trunksx64/KICAD_LIBRARY/3dmodels/x_Buzzer.3dhapes/AT_1224_TWT_5V_2_R.step

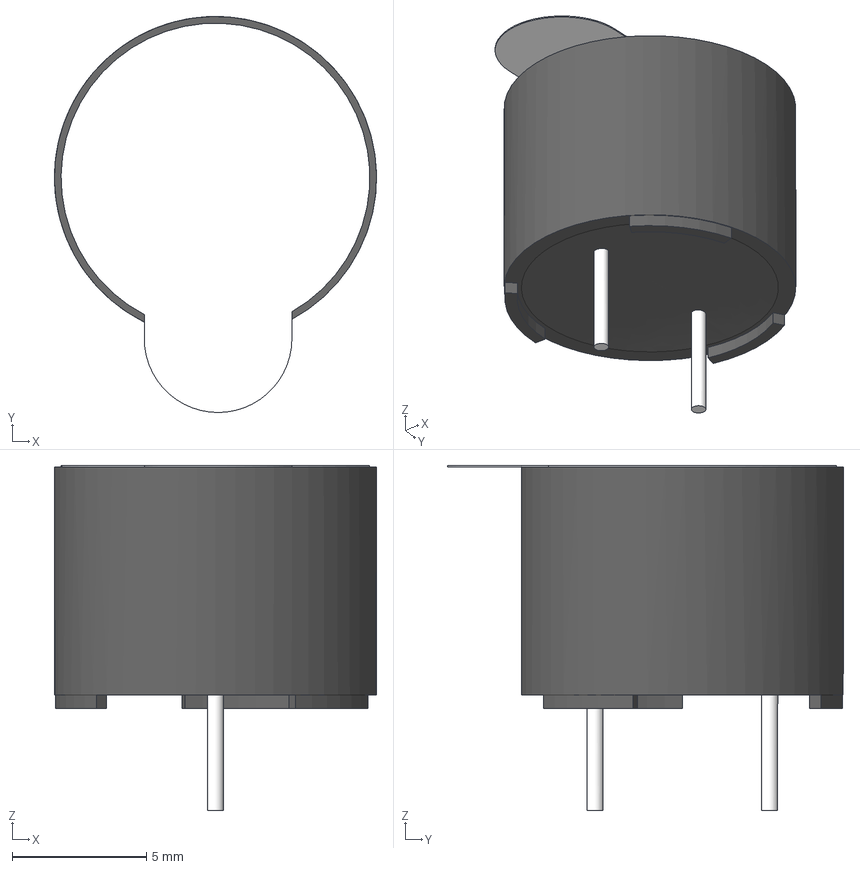
[picture p4: CAD file, 2026-03-22]
3dmodels/x_Buzzer.3dhapes/AT_1224_TWT_5V_2_R.step
12.0 x 14.7 x 12.9 mm
