trunksx64/KICAD_LIBRARY/3dmodels/x_Capacitors/KR-5R5V224-R.step

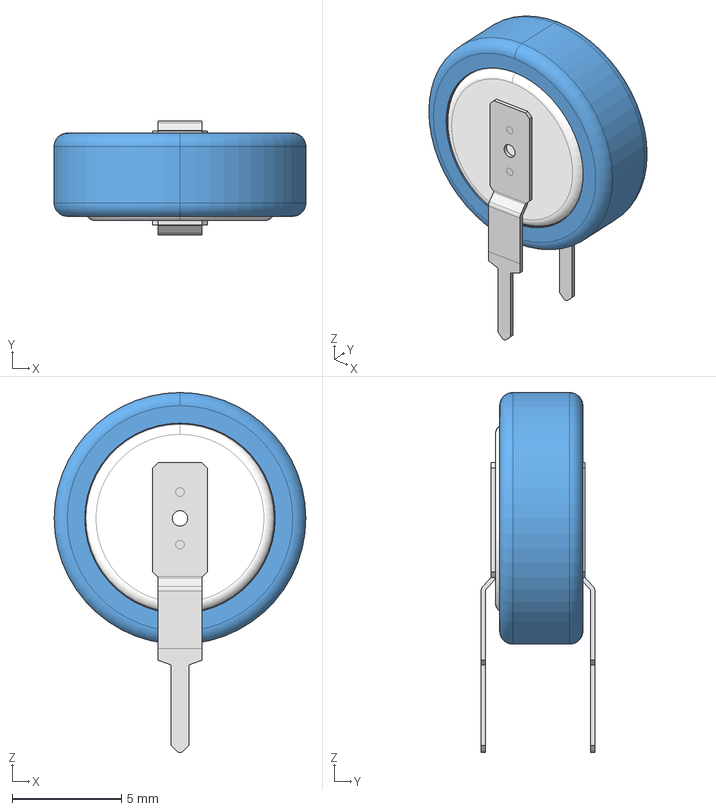
[picture p5: CAD file, 2026-02-24]
3dmodels/x_Capacitors/KR-5R5V224-R.step
11.5 x 5.20 x 16.4 mm
KR-5R5V104_224_334_474-R
KR-5R5V104_224_334_474-R001
KR-5R5V104_224_334_474-R002
KR-5R5V104_224_334_474-R003
KR-5R5V104_224_334_474-R004
KR-5R5V104_224_334_474-R005
