trunksx64/KICAD_LIBRARY/freecad/x_Arduino_Shield/ARDUINO_UNO_R3_PIN_HEADER.FCStd

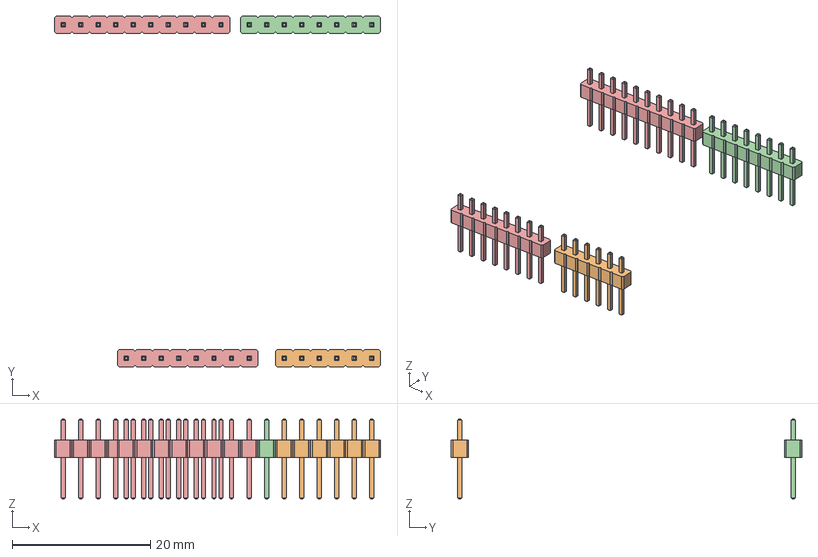
[picture p6: CAD file, 2025-01-12]
freecad/x_Arduino_Shield/ARDUINO_UNO_R3_PIN_HEADER.FCStd
47.2 x 50.8 x 11.5 mm
PinHeader_1x08_P254mm_001
PinHeader_1x06_P254mm_001
PinHeader_1x10_P254mm_001
PinHeader_1x08_P254mm_002
ARDUINO_UNO_R3_PIN_HEADER
