trunksx64/KICAD_LIBRARY/freecad/x_Battery/MS920SE_FL27E.FCStd

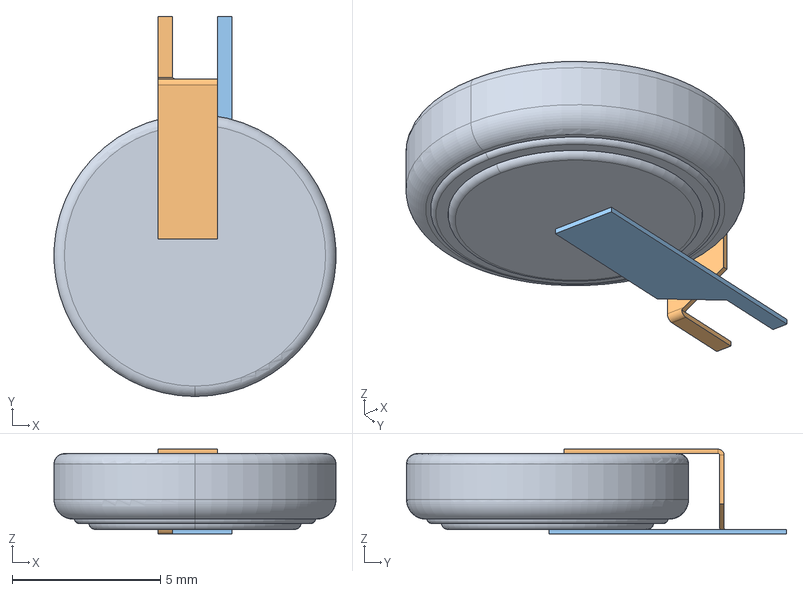
[picture p7: CAD file, 2025-09-22]
freecad/x_Battery/MS920SE_FL27E.FCStd
9.49 x 12.8 x 2.85 mm
MS920SE-FL27E_BODY
MS920SE-FL27E_PIN_P
MS920SE-FL27E_PIN_N
