trunksx64/KICAD_LIBRARY/freecad/x_Button_Switch_SMD/SWITCH_TACTILE_SPST_12x12mm_SMD.FCStd

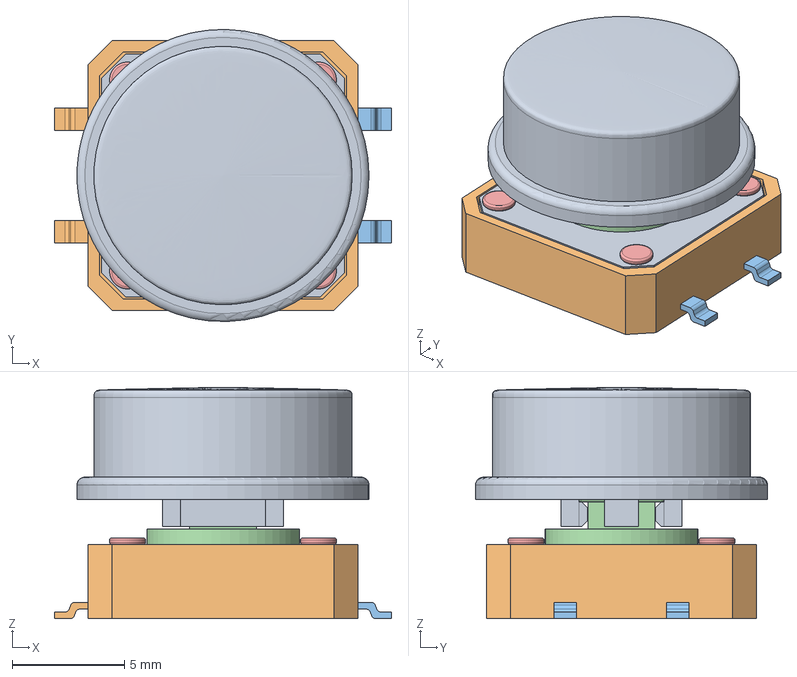
[picture p8: CAD file, 2025-01-12]
freecad/x_Button_Switch_SMD/SWITCH_TACTILE_SPST_12x12mm_SMD.FCStd
15.0 x 13.0 x 10.3 mm
Case
Base
PushFLat
PushSuport
ArrayLocks
Blue
Green
Red
Yellow
PinAS
PinBS
