trunksx64/KICAD_LIBRARY/freecad/x_Button_Switch_THT/SWITCH_TACTILE_SPST_6x3.5mm_THT.FCStd

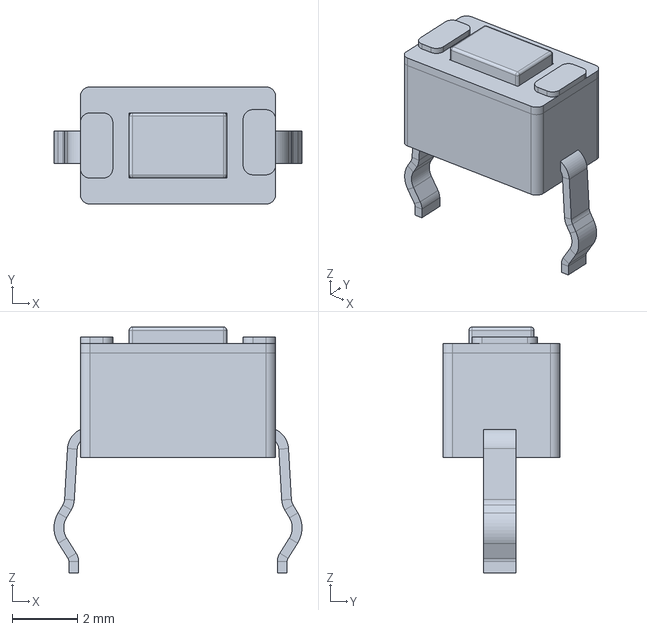
[picture p9: CAD file, 2025-07-24]
freecad/x_Button_Switch_THT/SWITCH_TACTILE_SPST_6x3.5mm_THT.FCStd
7.61 x 3.60 x 7.55 mm
