trunksx64/KICAD_LIBRARY/freecad/x_Connector_Card/DM3AT_SF_PEJM5.FCStd

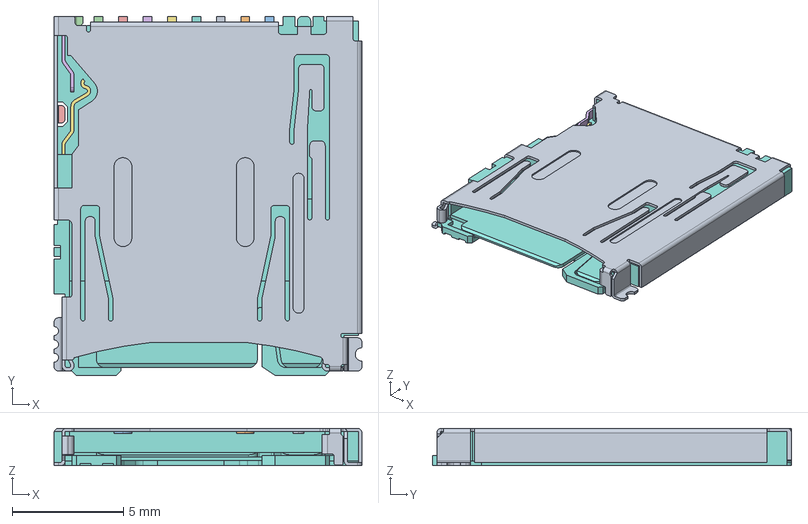
[picture p10: CAD file, 2025-05-25]
freecad/x_Connector_Card/DM3AT_SF_PEJM5.FCStd
13.8 x 16.2 x 1.68 mm
DM3AT-SF-PEJM5
DM3AT-SF-PEJM006
DM3AT-SF-PEJM007
DM3AT-SF-PEJM008
DM3AT-SF-PEJM009
DM3AT-SF-PEJM010
DM3AT-SF-PEJM011
DM3AT-SF-PEJM012
DM3AT-SF-PEJM013
DM3AT-SF-PEJM014
DM3AT-SF-PEJM015
DM3AT-SF-PEJM016
DM3AT-SF-PEJM017
DM3AT-SF-PEJM018
DM3AT-SF-PEJM019
DM3AT-SF-PEJM020
DM3AT-SF-PEJM021
