trunksx64/KICAD_LIBRARY/freecad/x_Connector_FFC_FPC/TE_4_1734839_0_1x40_1MP_P0.5mm_H.FCStd

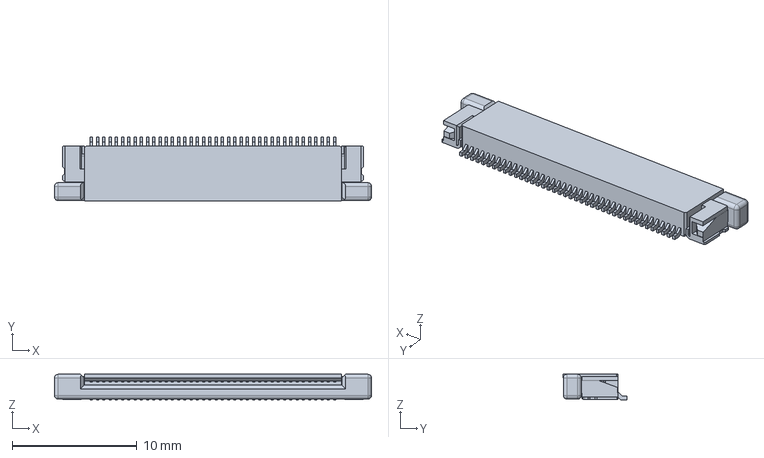
[picture p11: CAD file, 2025-01-12]
freecad/x_Connector_FFC_FPC/TE_4_1734839_0_1x40_1MP_P0.5mm_H.FCStd
25.4 x 5.11 x 2.05 mm
