trunksx64/KICAD_LIBRARY/freecad/x_Connector_FTSH/FTSH_107_01_L_DV_K.FCStd

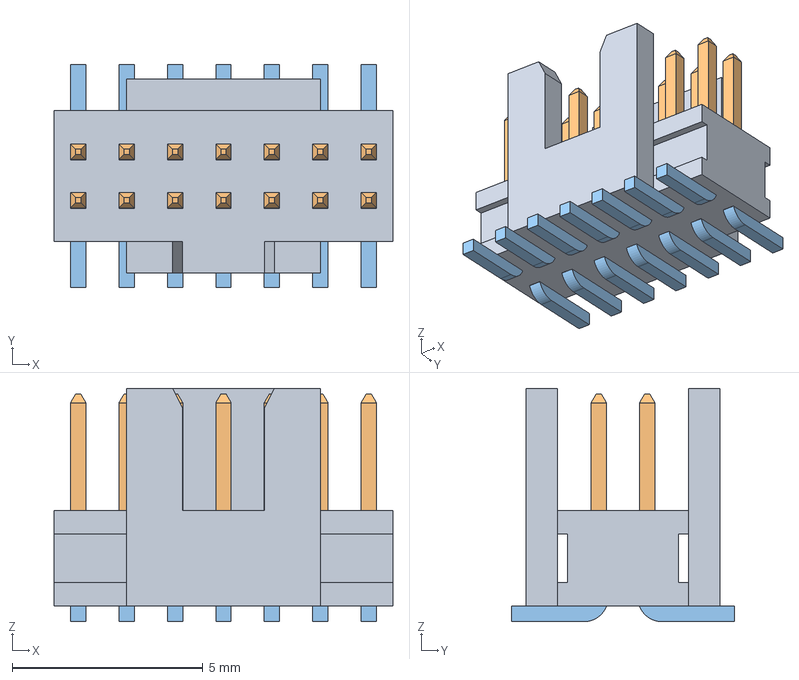
[picture p12: CAD file, 2025-10-27]
freecad/x_Connector_FTSH/FTSH_107_01_L_DV_K.FCStd
8.89 x 5.84 x 6.12 mm
FTSH-107-01-L-DV-K_body
FTSH-107-01-L-DV-K_pins1
FTSH-107-01-L-DV-K_pins2
