trunksx64/KICAD_LIBRARY/freecad/x_Connector_IDC/IDC_Header_2x07_P21.27mm_Vertical.FCStd

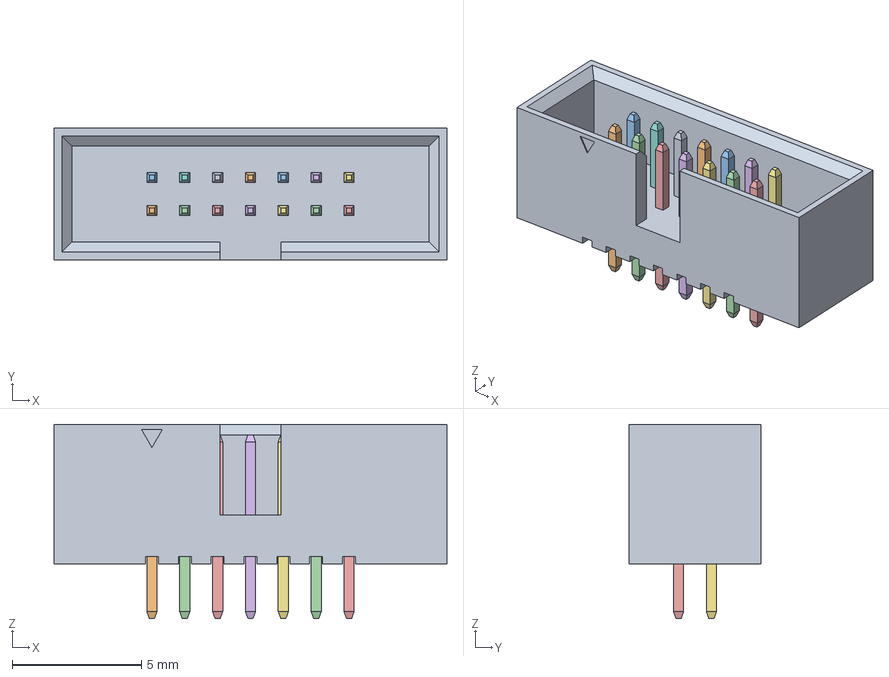
[picture p13: CAD file, 2026-02-07]
freecad/x_Connector_IDC/IDC_Header_2x07_P21.27mm_Vertical.FCStd
15.2 x 5.10 x 7.50 mm
3220-xx-0100-00 body_14
Pin^3220-xx-0100-00
Pin^3220-xx-0100-001
Pin^3220-xx-0100-002
Pin^3220-xx-0100-003
Pin^3220-xx-0100-004
Pin^3220-xx-0100-005
Pin^3220-xx-0100-006
Pin^3220-xx-0100-007
Pin^3220-xx-0100-008
Pin^3220-xx-0100-009
Pin^3220-xx-0100-010
Pin^3220-xx-0100-011
Pin^3220-xx-0100-012
Pin^3220-xx-0100-013
