trunksx64/KICAD_LIBRARY/freecad/x_Connector_Molex/MOLEX_MINI_FIT_02x02_P4.20mm_HORIZONTAL.FCStd

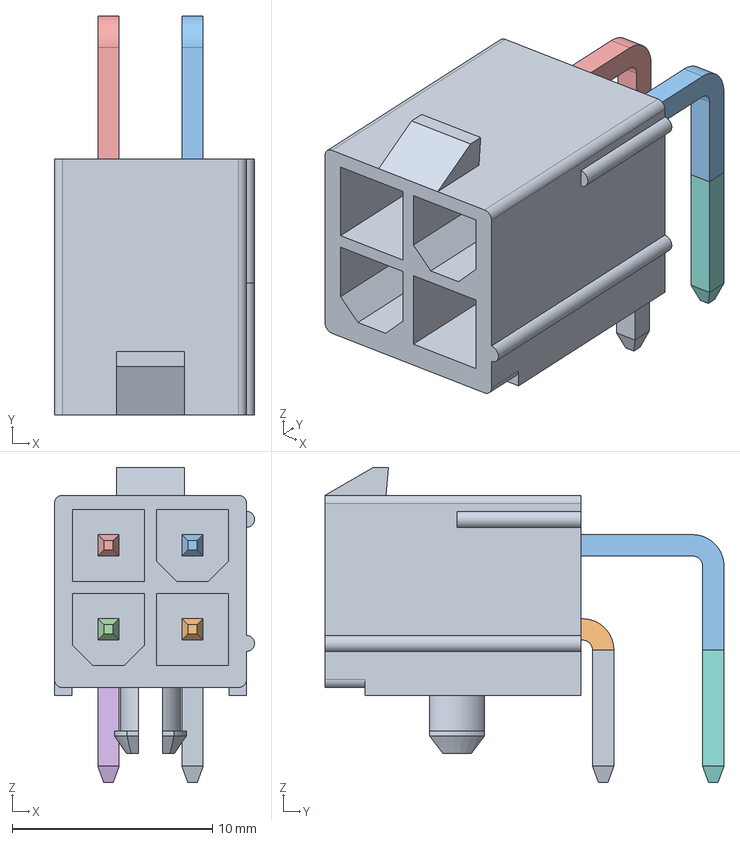
[picture p14: CAD file, 2025-04-12]
freecad/x_Connector_Molex/MOLEX_MINI_FIT_02x02_P4.20mm_HORIZONTAL.FCStd
10.00 x 19.9 x 15.8 mm
