trunksx64/KICAD_LIBRARY/freecad/x_Connector_RJ/RJ12_Vertical.FCStd

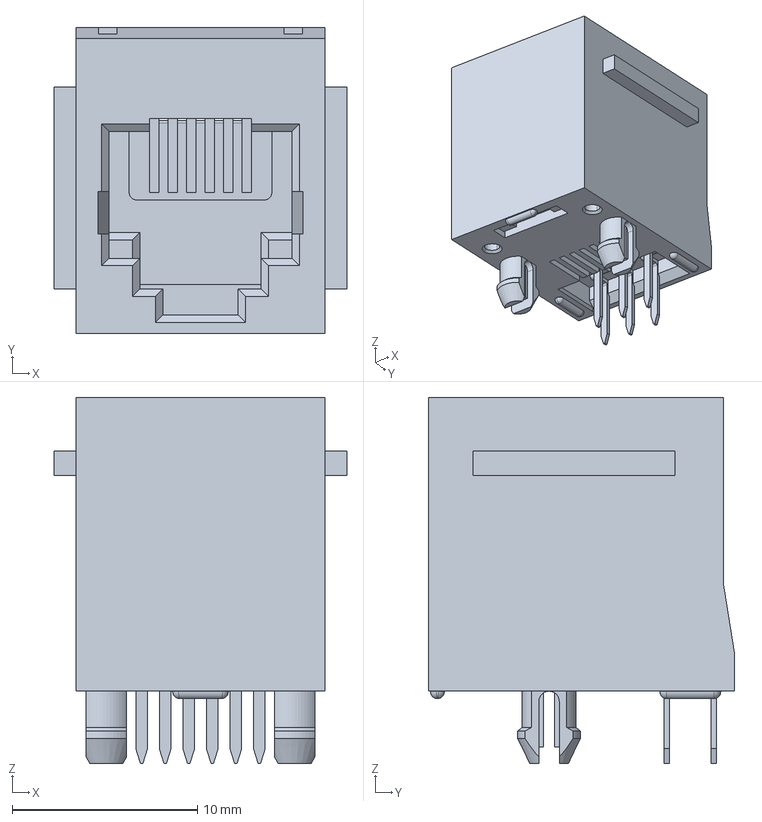
[picture p15: CAD file, 2025-01-12]
freecad/x_Connector_RJ/RJ12_Vertical.FCStd
15.8 x 16.5 x 19.8 mm
