trunksx64/KICAD_LIBRARY/freecad/x_Connector_USB/USB_B_LUMBERG_2411_HORIZONTAL.FCStd

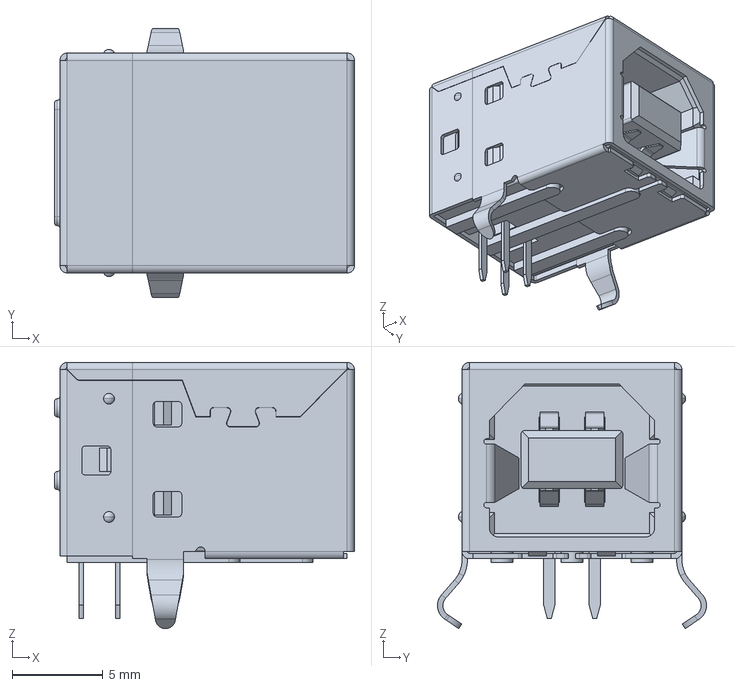
[picture p16: CAD file, 2025-01-12]
freecad/x_Connector_USB/USB_B_LUMBERG_2411_HORIZONTAL.FCStd
16.5 x 14.8 x 14.6 mm
