trunksx64/KICAD_LIBRARY/freecad/x_Crystal/Crystal_SMD_ABS25_4Pin_8.0x3.8mm.FCStd

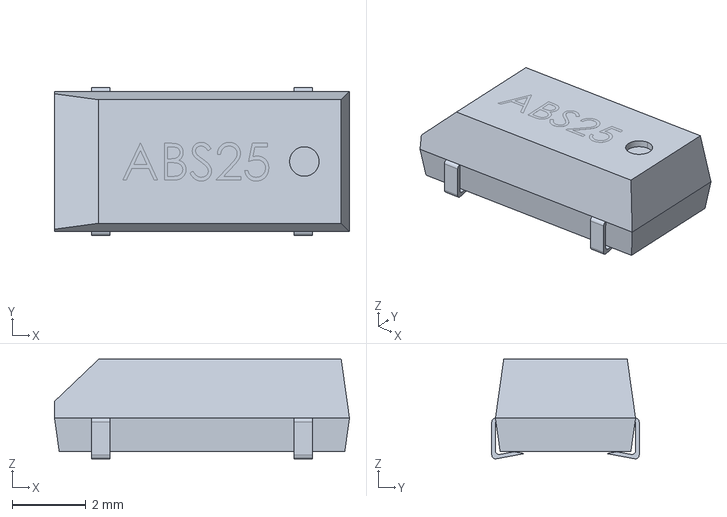
[picture p17: CAD file, 2025-01-12]
freecad/x_Crystal/Crystal_SMD_ABS25_4Pin_8.0x3.8mm.FCStd
8.00 x 4.00 x 2.71 mm
