trunksx64/KICAD_LIBRARY/freecad/x_Diode_SMD/DO_214AC(SMA).FCStd

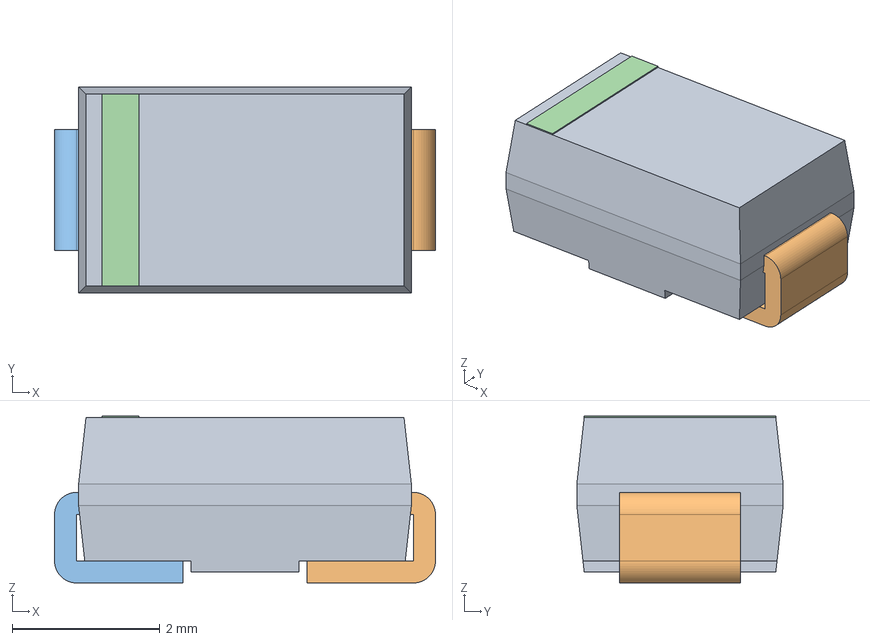
[picture p18: CAD file, 2025-01-12]
freecad/x_Diode_SMD/DO_214AC(SMA).FCStd
5.15 x 2.79 x 2.26 mm
Cut_K
Pin_1K
Pin_2K
Extrude_K
