trunksx64/KICAD_LIBRARY/freecad/x_Display_7Segment/KW3_S561AWB.FCStd

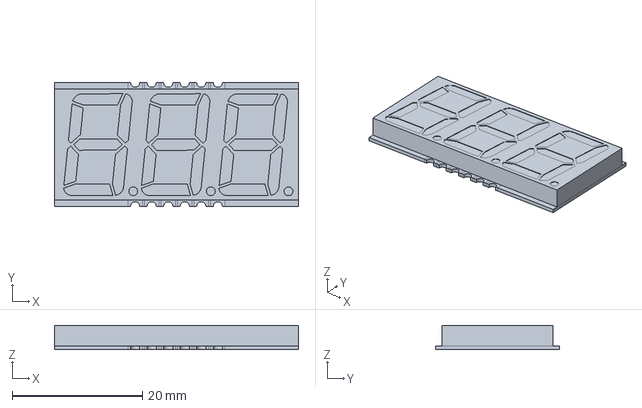
[picture p19: CAD file, 2025-07-22]
freecad/x_Display_7Segment/KW3_S561AWB.FCStd
37.5 x 19.0 x 3.75 mm
