trunksx64/KICAD_LIBRARY/freecad/x_Display_Driver/MAX6951.FCStd

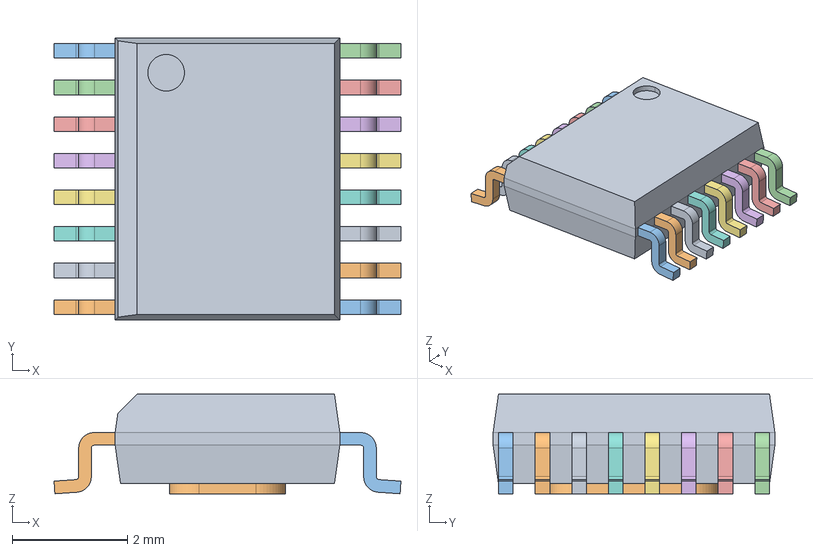
[picture p20: CAD file, 2025-07-24]
freecad/x_Display_Driver/MAX6951.FCStd
6.02 x 4.89 x 1.73 mm
MAX6951_001
MAX6951_002
MAX6951_003
MAX6951_004
MAX6951_005
MAX6951_006
MAX6951_007
MAX6951_008
MAX6951_009
MAX6951_010
MAX6951_011
MAX6951_012
MAX6951_013
MAX6951_014
MAX6951_015
MAX6951_016
MAX6951_017
MAX695_018
