trunksx64/KICAD_LIBRARY/freecad/x_Display_GLCD/GLCD_OLLED_128x32_I2C.FCStd

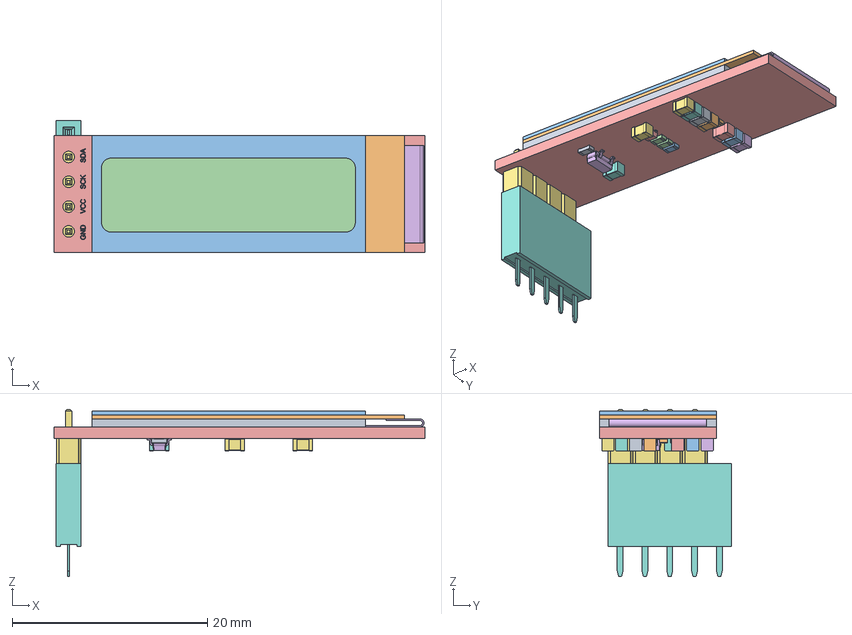
[picture p21: CAD file, 2025-09-22]
freecad/x_Display_GLCD/GLCD_OLLED_128x32_I2C.FCStd
38.0 x 13.6 x 17.2 mm
SCREEN_30x12mm_A
SCREEN_30x12mm_B
SCREEN_30x12mm_C
SCREEN_30x12mm_D
PCB_38x12mm
FLEX
PinHeader_1x04_P254mm_Vertical
PinSocket_1x05_P2.54mm_Vertical
TEXT_GND
TEXT_VCC
TEXT_SCK
TEXT_SDA
D_SC_80
SOT-23-3
C_0805_2012Metric_002
C_0805_2012Metric_003
R_0603_1608Metric_002
R_0603_1608Metric_000
C_0805_2012Metric_000
R_0603_1608Metric_001
C_0805_2012Metric_004
C_0805_2012Metric_005
C_0805_2012Metric_006
C_0805_2012Metric_007
C_0805_2012Metric_008
C_0805_2012Metric_009
R_0603_1608Metric_003
R_0603_1608Metric_004
