trunksx64/KICAD_LIBRARY/freecad/x_Display_Matrix/1088AS.FCStd

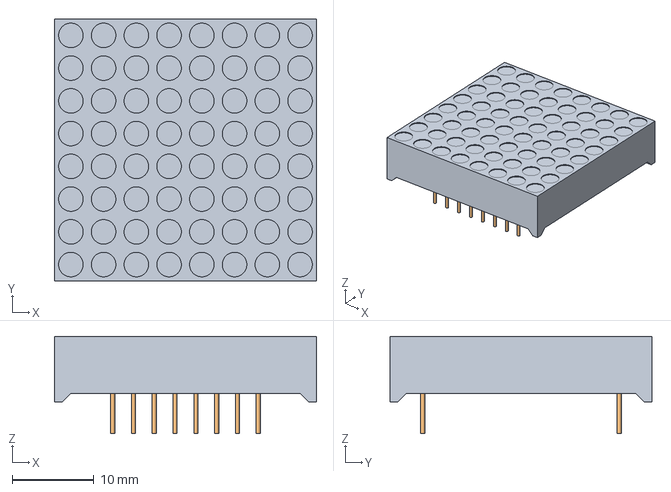
[picture p22: CAD file, 2025-01-12]
freecad/x_Display_Matrix/1088AS.FCStd
32.0 x 32.0 x 11.9 mm
BasePlastic
Pins001
