trunksx64/KICAD_LIBRARY/freecad/x_Fuses/MF_SMDF200.FCStd

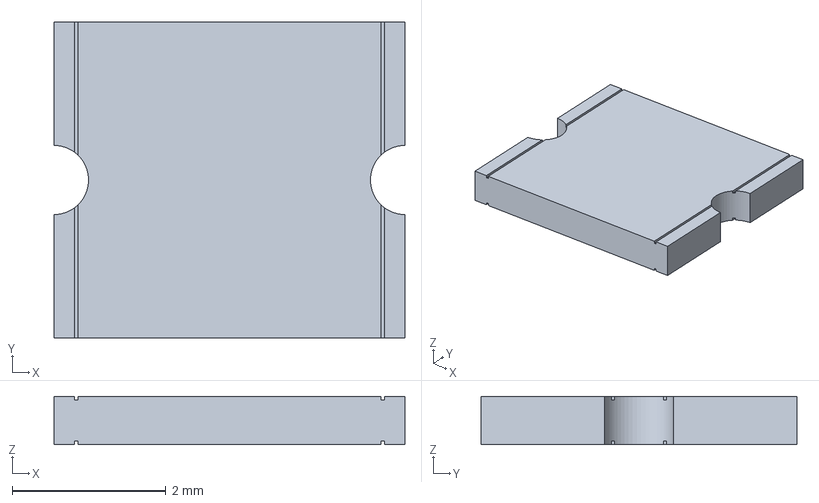
[picture p23: CAD file, 2025-01-12]
freecad/x_Fuses/MF_SMDF200.FCStd
4.57 x 4.12 x 0.63 mm
