trunksx64/KICAD_LIBRARY/freecad/x_Inductor_SMD/L_Bourns_SRN1060.FCStd

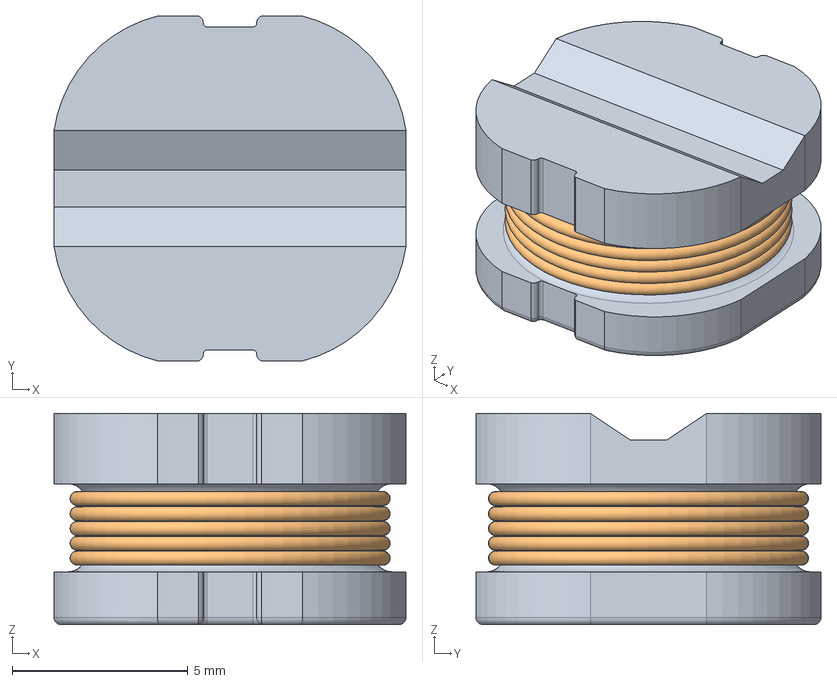
[picture p24: CAD file, 2025-01-12]
freecad/x_Inductor_SMD/L_Bourns_SRN1060.FCStd
10.0 x 9.80 x 6.00 mm
L_Bourns-SRN1060
