trunksx64/KICAD_LIBRARY/freecad/x_Inductor_THT/AC_COMMON_COIL_H16.2mm_W21.0mm_Py10.mm_Px13.mm.FCStd

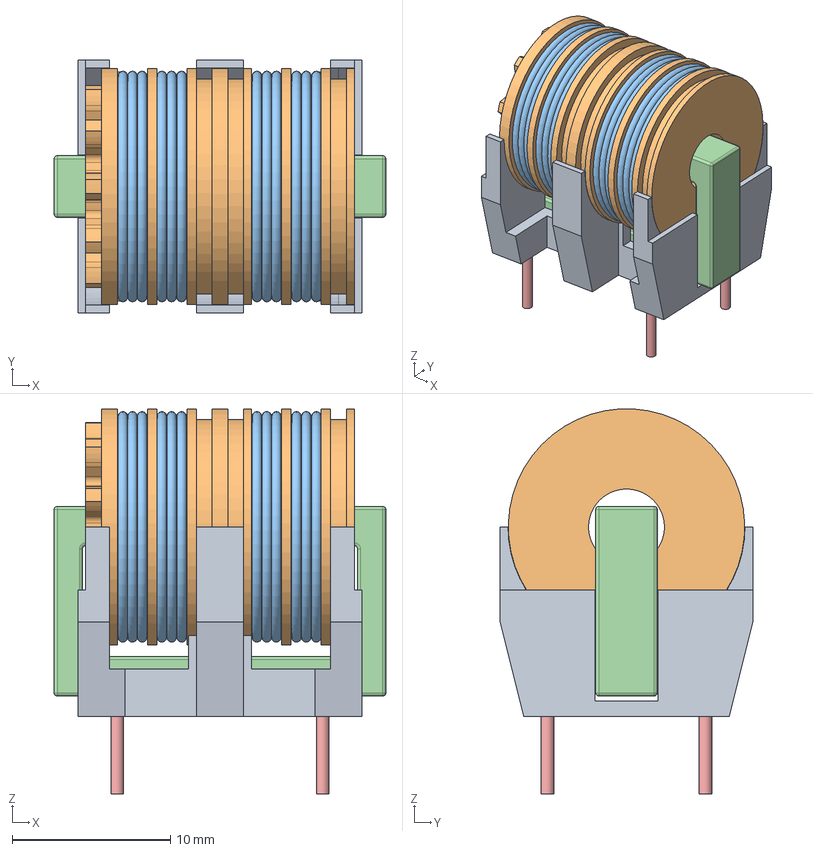
[picture p25: CAD file, 2025-01-12]
freecad/x_Inductor_THT/AC_COMMON_COIL_H16.2mm_W21.0mm_Py10.mm_Px13.mm.FCStd
21.0 x 16.0 x 24.4 mm
Base_K
Plastic_K
Copper_K
Ferrite_K
Pins_K
