trunksx64/KICAD_LIBRARY/freecad/x_Joystick/JOYSTICK_ALPS_3318.FCStd

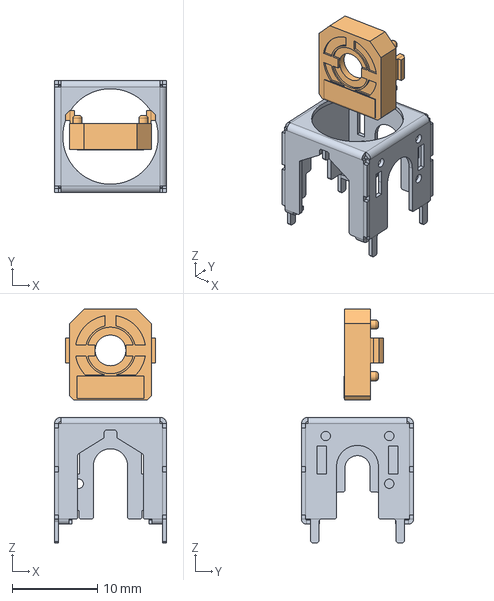
[picture p26: CAD file, 2025-01-12]
freecad/x_Joystick/JOYSTICK_ALPS_3318.FCStd
13.2 x 13.2 x 27.5 mm
CHASSIS
CONTROLLER
