trunksx64/KICAD_LIBRARY/freecad/x_Jumpers/JUMPER_2.54MM.FCStd

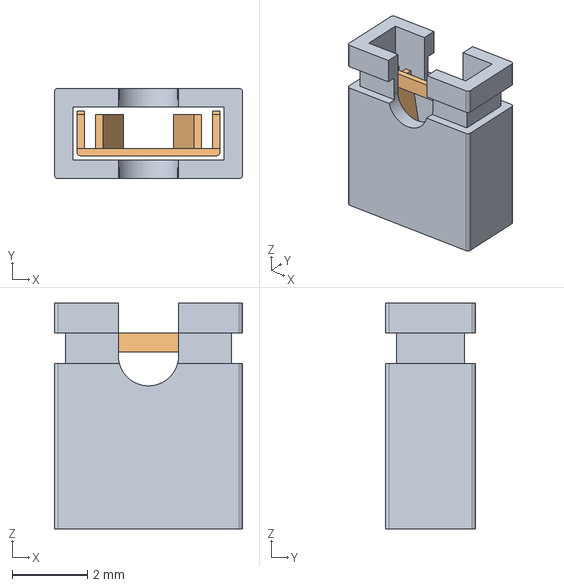
[picture p27: CAD file, 2025-01-12]
freecad/x_Jumpers/JUMPER_2.54MM.FCStd
5.00 x 2.40 x 6.00 mm
COPPER
PLASTIC
