trunksx64/KICAD_LIBRARY/freecad/x_Led_SMD/LED_1210RVC.FCStd

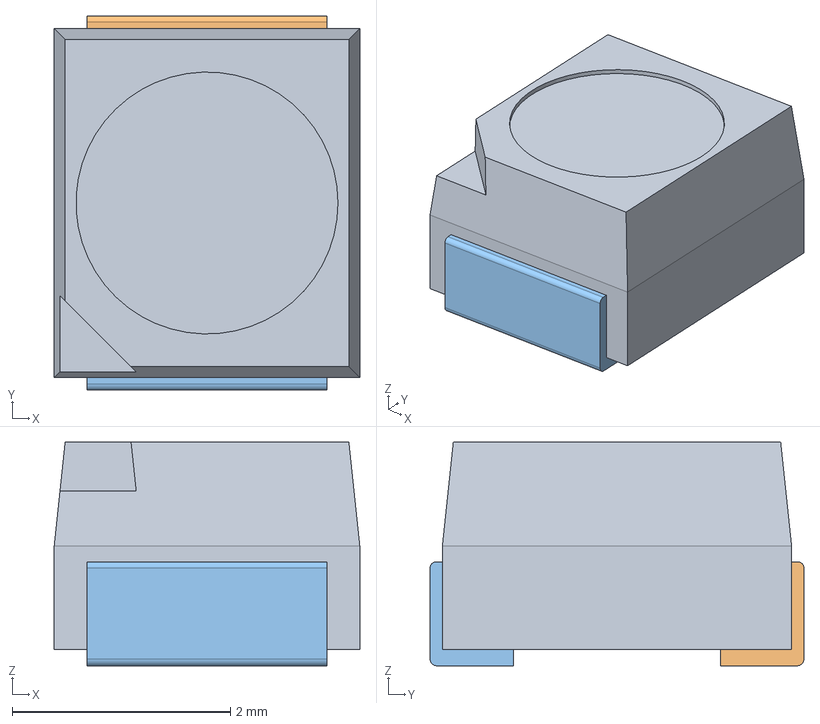
[picture p28: CAD file, 2025-01-12]
freecad/x_Led_SMD/LED_1210RVC.FCStd
2.80 x 3.43 x 2.05 mm
Plastic
PinPad1
PinPad2
