trunksx64/KICAD_LIBRARY/freecad/x_Module/BREAKOUT_BOAD_LQFN64.FCStd

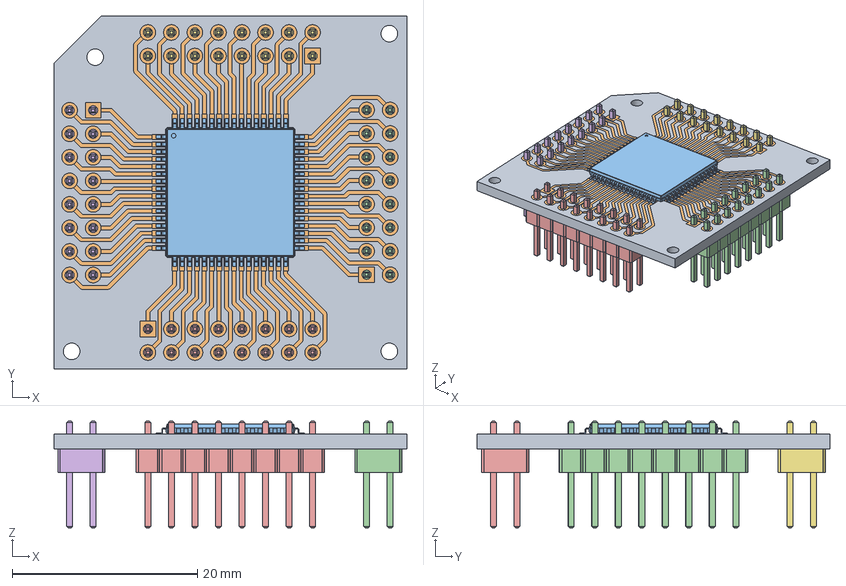
[picture p29: CAD file, 2025-01-12]
freecad/x_Module/BREAKOUT_BOAD_LQFN64.FCStd
38.1 x 38.1 x 11.5 mm
PCB
TRACKS
TQFP_64
PIN_HEADER_001
PIN_HEADER_002
PIN_HEADER_003
PIN_HEADER_004
