trunksx64/KICAD_LIBRARY/freecad/x_OptoDevice/PHOTO_CELL_VT900.FCStd

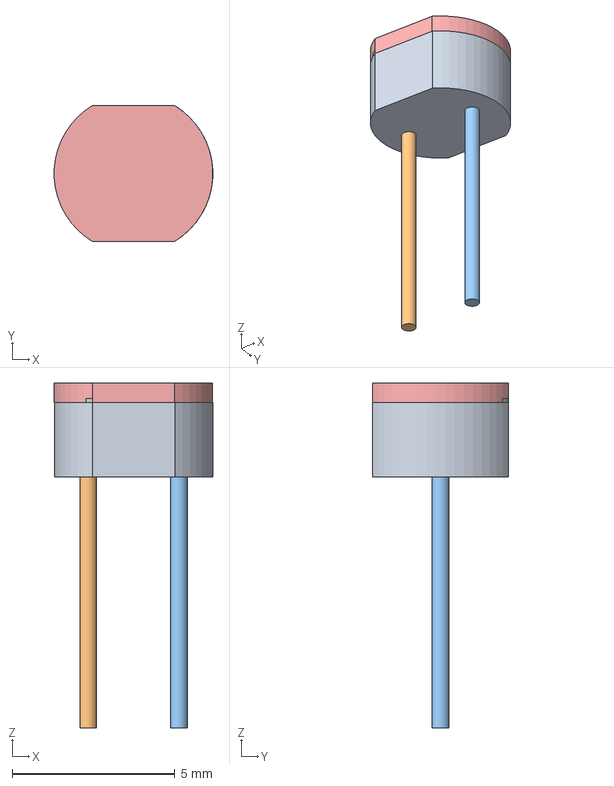
[picture p30: CAD file, 2025-01-12]
freecad/x_OptoDevice/PHOTO_CELL_VT900.FCStd
4.87 x 4.17 x 10.6 mm
Pin001
Pin002
Resistencia001
Glass001
