trunksx64/KICAD_LIBRARY/freecad/x_Package_DFN_QFN/QFN_16_3x3x1mm_P0.5mm.FCStd

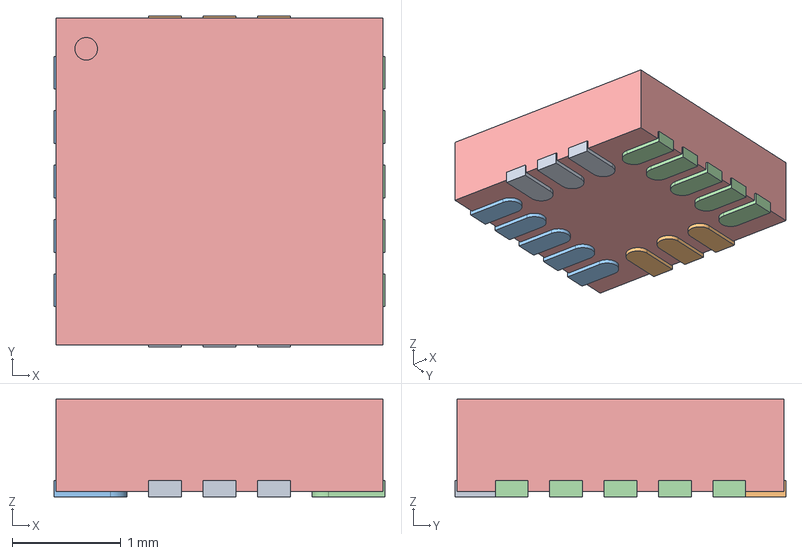
[picture p31: CAD file, 2025-01-12]
freecad/x_Package_DFN_QFN/QFN_16_3x3x1mm_P0.5mm.FCStd
3.04 x 3.04 x 0.9 mm
Pins1
Pins2
Pins3
Pins4
Resine
