trunksx64/KICAD_LIBRARY/freecad/x_Package_DIP/SMDIP_6_W8.51mm.FCStd

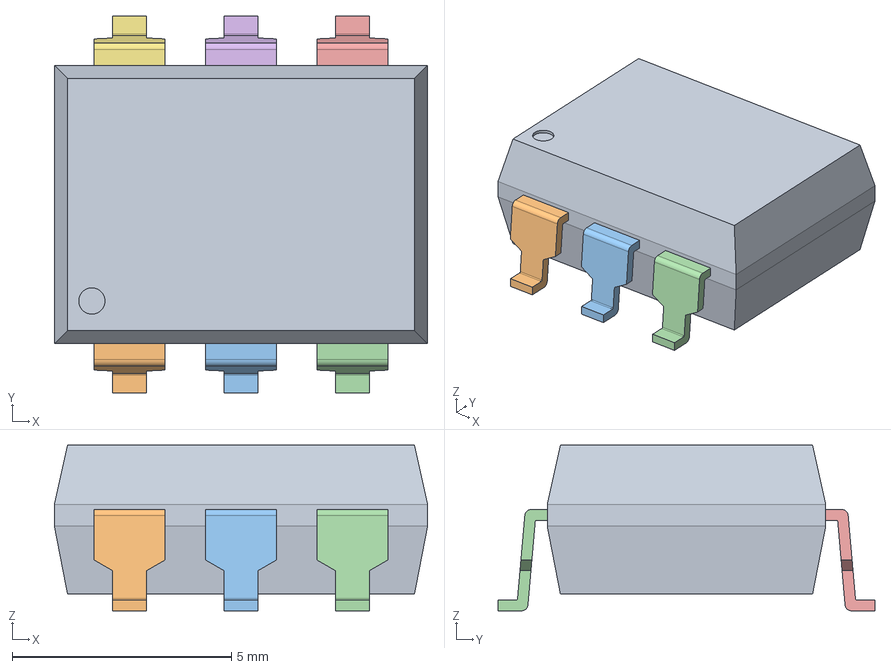
[picture p32: CAD file, 2025-01-12]
freecad/x_Package_DIP/SMDIP_6_W8.51mm.FCStd
8.51 x 8.60 x 3.78 mm
Body_K
Pin01_K
Pin02_K
Pin03_K
Pin04_K
Pin05_K
Pin06_K
