trunksx64/KICAD_LIBRARY/freecad/x_Package_QFP/LQFN_44_10x10x1.4mm_P0.8mm_EP5.2x5.2mm.FCStd

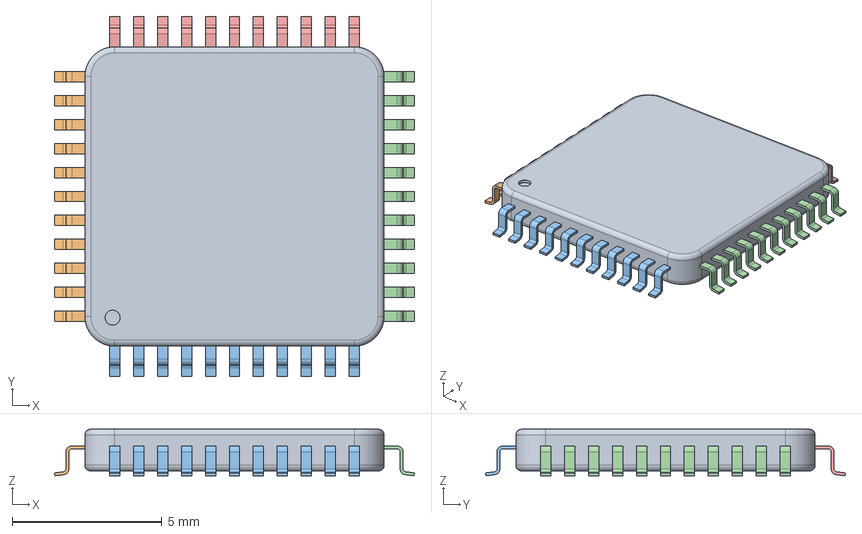
[picture p33: CAD file, 2025-01-12]
freecad/x_Package_QFP/LQFN_44_10x10x1.4mm_P0.8mm_EP5.2x5.2mm.FCStd
12.0 x 12.0 x 1.56 mm
Resine
Pin1
Pin2
Pin3
Pin4
