trunksx64/KICAD_LIBRARY/freecad/x_Package_TO_SOT_THT/SOT-523.FCStd

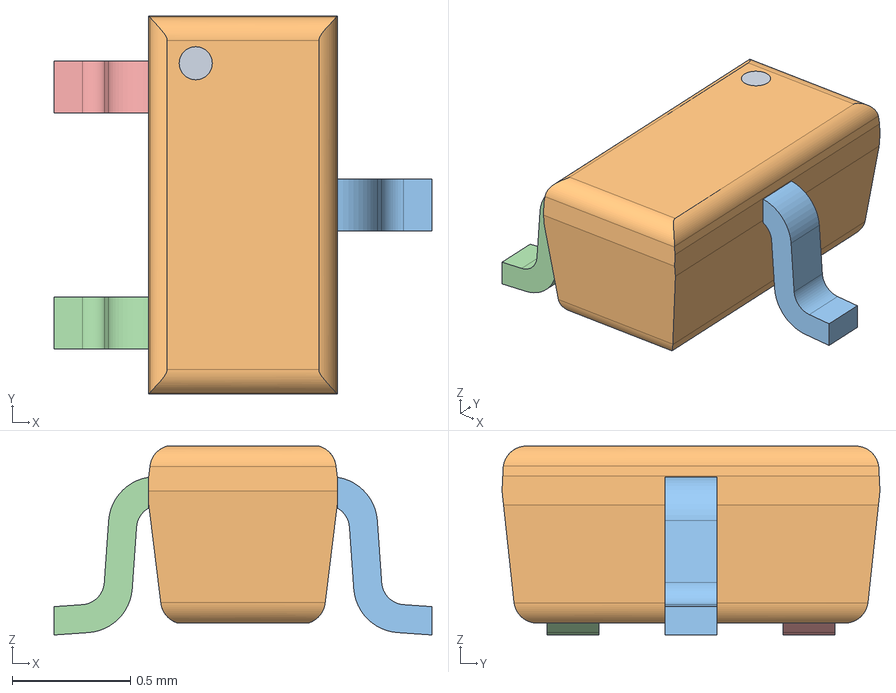
[picture p34: CAD file, 2026-02-24]
freecad/x_Package_TO_SOT_THT/SOT-523.FCStd
1.60 x 1.60 x 0.8 mm
SOT-523-F
SOT-523-F001
SOT-523-F002
SOT-523-F003
SOT-523-F004
