trunksx64/KICAD_LIBRARY/freecad/x_Relay_THT/HRS2H_S.FCStd

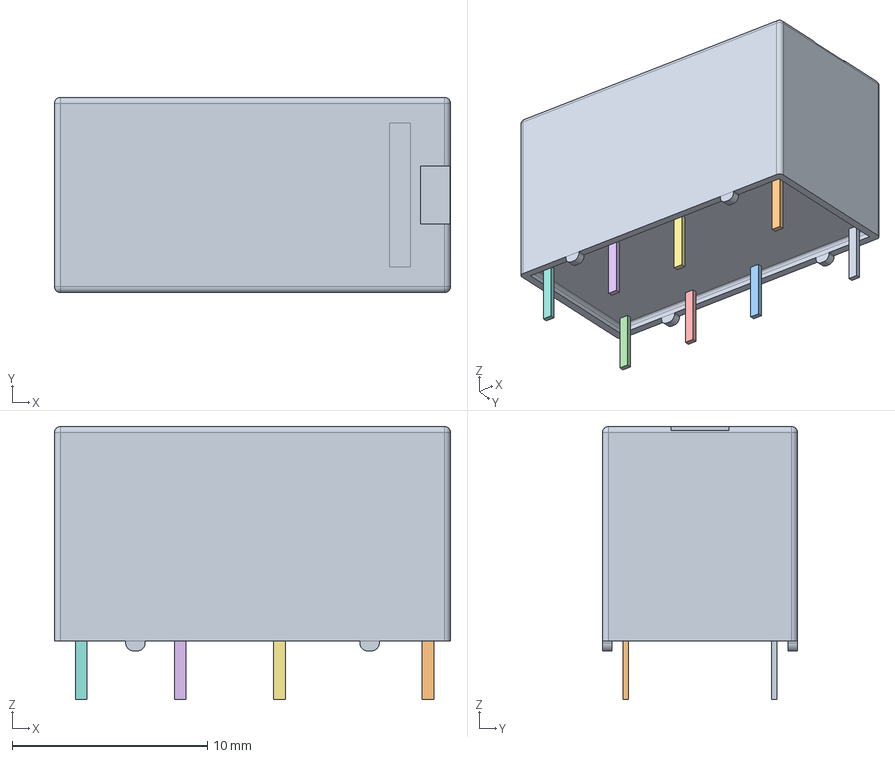
[picture p35: CAD file, 2025-01-12]
freecad/x_Relay_THT/HRS2H_S.FCStd
20.3 x 10.0 x 14.0 mm
Body_B
PIN_016
PIN_015
PIN_014
PIN_013
PIN_012
PIN_011
PIN_010
PIN_009
