trunksx64/KICAD_LIBRARY/freecad/x_Sockets_ZIF/SOCKET_28P_W50.4_H14.9_P7.62x2.45.FCStd

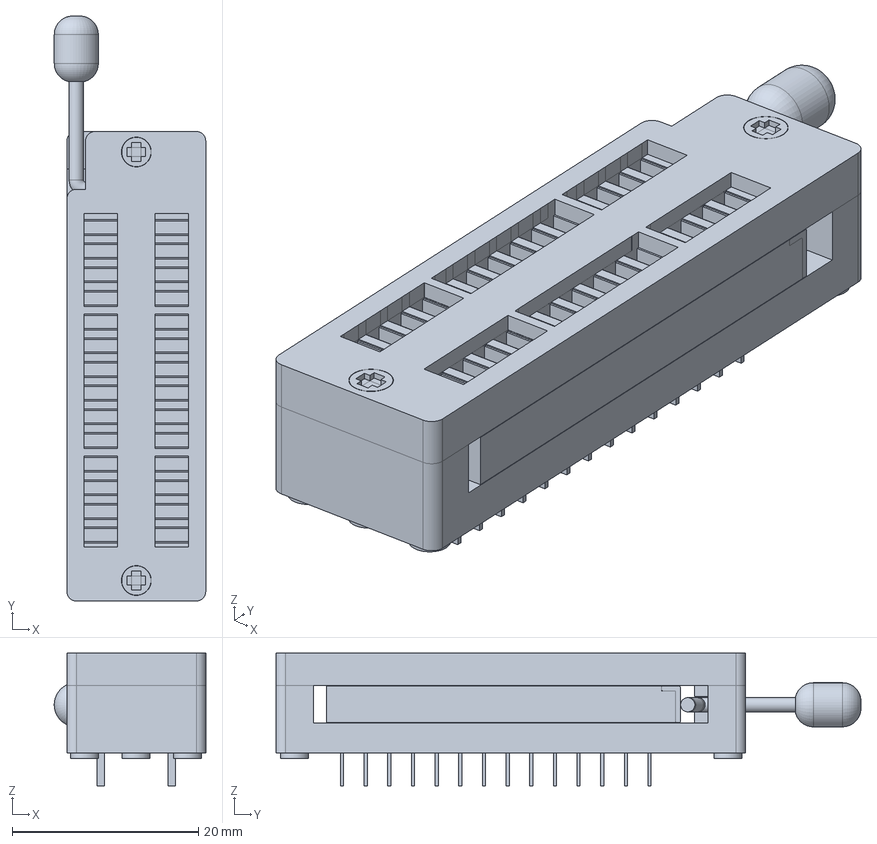
[picture p37: CAD file, 2025-07-22]
freecad/x_Sockets_ZIF/SOCKET_28P_W50.4_H14.9_P7.62x2.45.FCStd
16.3 x 62.8 x 14.3 mm
