trunksx64/KICAD_LIBRARY/3dmodels/x_Capacitors/Cap_Disc_D5.0mm_W2.5mm_H7.8MM_P5.00mm.step

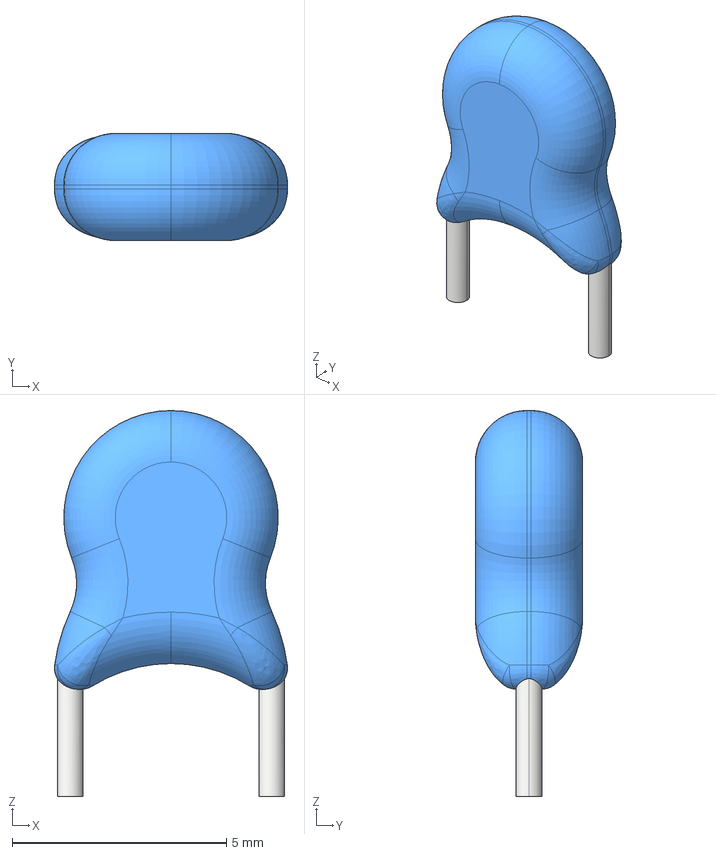
[picture p38: CAD file, 2025-01-17]
3dmodels/x_Capacitors/Cap_Disc_D5.0mm_W2.5mm_H7.8MM_P5.00mm.step
5.44 x 2.50 x 9.00 mm
