trunksx64/KICAD_LIBRARY/freecad/x_Battery/XH4141H.FCStd

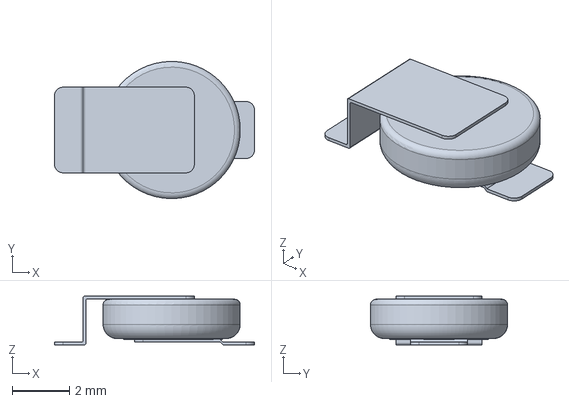
[picture p39: CAD file, 2025-01-12]
freecad/x_Battery/XH4141H.FCStd
7.00 x 4.80 x 1.71 mm
