trunksx64/KICAD_LIBRARY/freecad/x_Button_Switch_THT/SWITCH_TACTILE_SPST_12x12mm_THT.FCStd

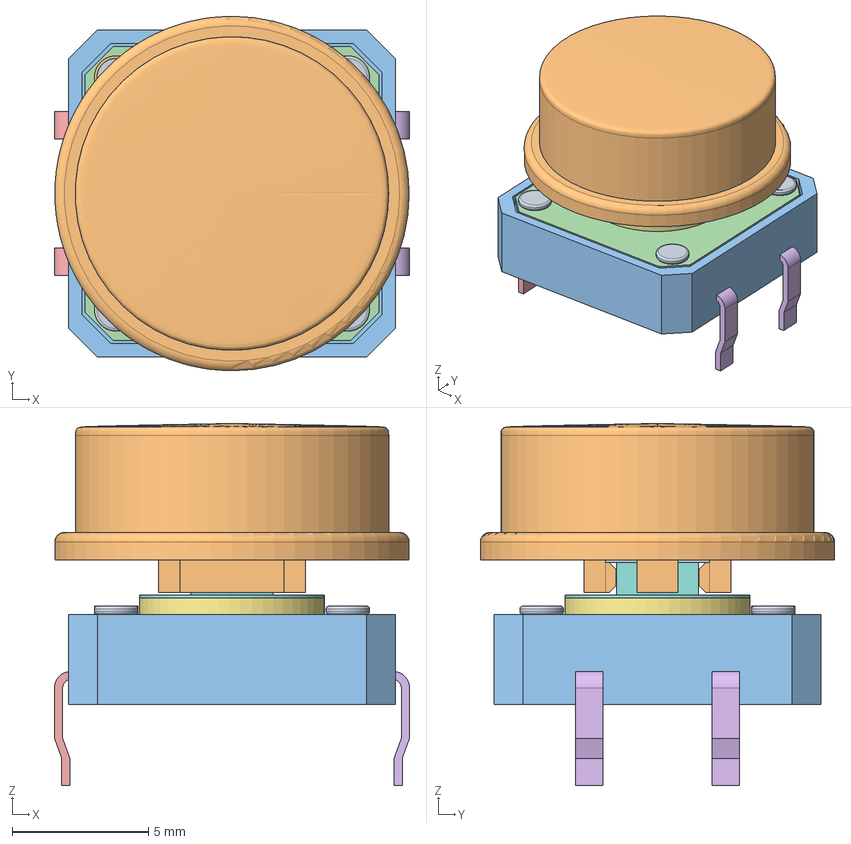
[picture p40: CAD file, 2025-01-12]
freecad/x_Button_Switch_THT/SWITCH_TACTILE_SPST_12x12mm_THT.FCStd
13.0 x 13.0 x 13.3 mm
Suport
Lock
Base
Case
PinBT
PinAT
PushFLat
PushSuport
ArrayLocks
Yellow
