trunksx64/KICAD_LIBRARY/freecad/x_Connector_FTSH/FTSH_107_01_S_D_K.FCStd

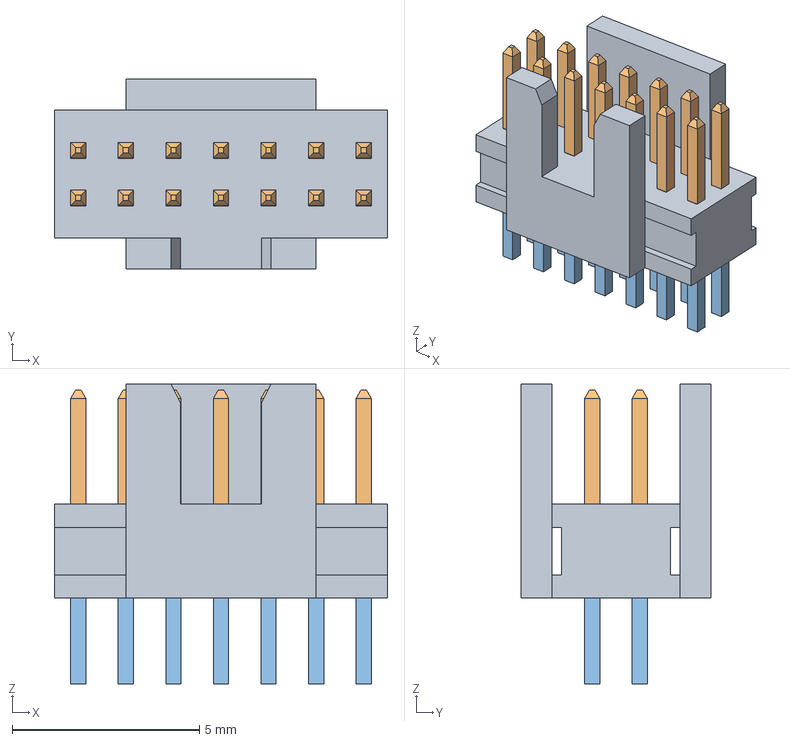
[picture p41: CAD file, 2025-10-27]
freecad/x_Connector_FTSH/FTSH_107_01_S_D_K.FCStd
8.89 x 5.08 x 8.00 mm
FTSH-107-01-S-D-K_body
FTSH-107-01-S-D-K_pins1
FTSH-107-01-S-D-K_pins2
