trunksx64/KICAD_LIBRARY/freecad/x_Connector_Molex/MOLEX_KK_1x03_P2.54mm_HORIZONTAL.FCStd

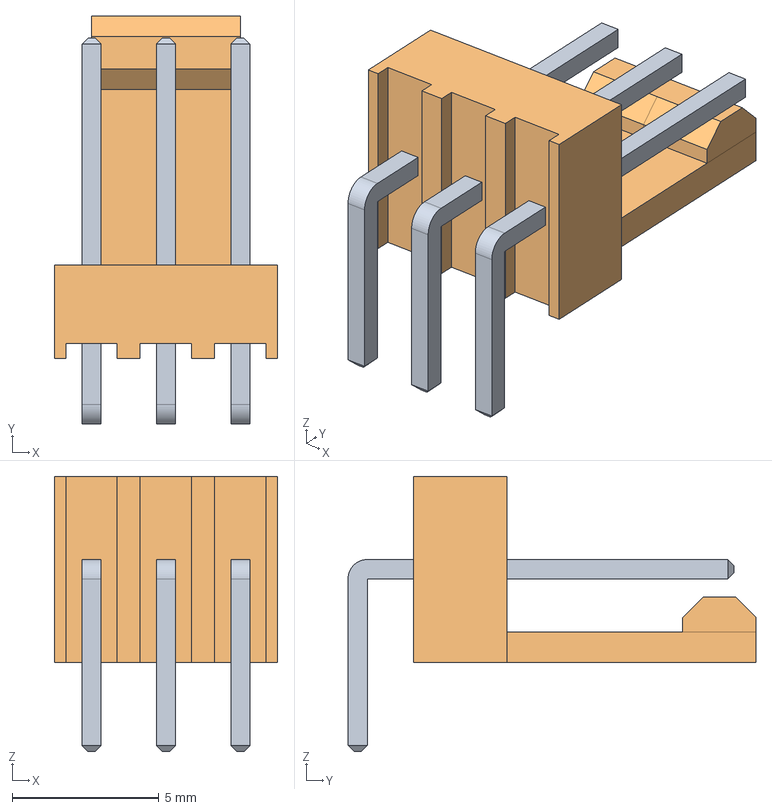
[picture p42: CAD file, 2025-01-12]
freecad/x_Connector_Molex/MOLEX_KK_1x03_P2.54mm_HORIZONTAL.FCStd
7.62 x 13.9 x 9.39 mm
ArrayP
Base
