trunksx64/KICAD_LIBRARY/freecad/x_Connector_RJ/RJ10_GLX_A_44.FCStd

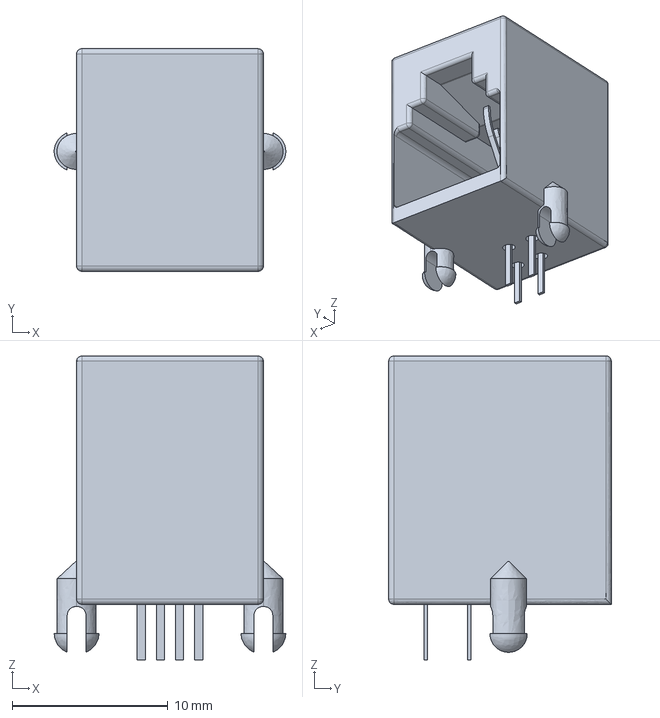
[picture p43: CAD file, 2025-01-12]
freecad/x_Connector_RJ/RJ10_GLX_A_44.FCStd
14.9 x 14.3 x 19.5 mm
