trunksx64/KICAD_LIBRARY/freecad/x_Connector_USB/USB_MICRO_B_VERTICAL.FCStd

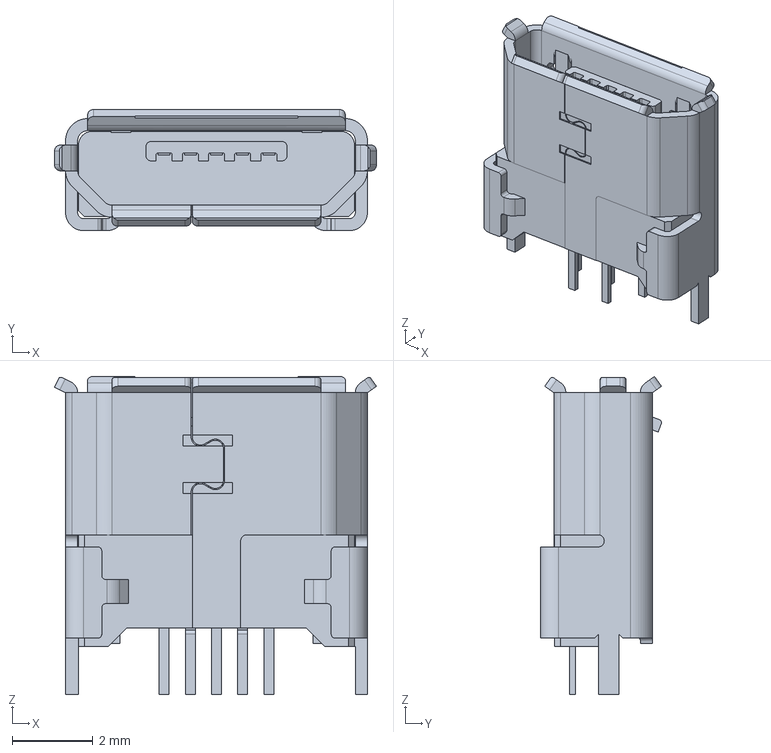
[picture p44: CAD file, 2025-01-12]
freecad/x_Connector_USB/USB_MICRO_B_VERTICAL.FCStd
8.00 x 3.01 x 7.91 mm
