trunksx64/KICAD_LIBRARY/freecad/x_Crystal/MS1V_T1K_32.768KHZ_7PF_20PPM_TA.FCStd

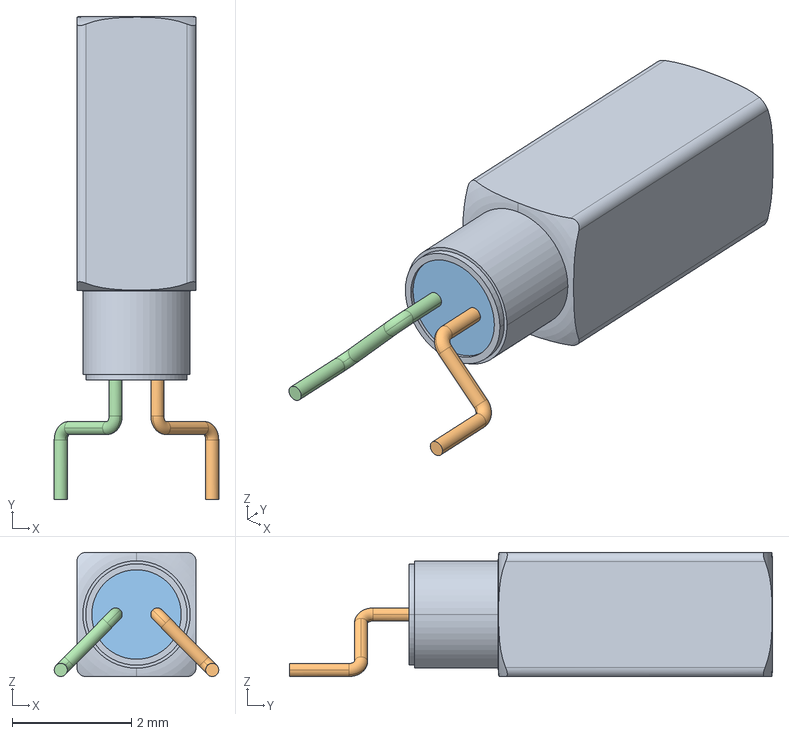
[picture p45: CAD file, 2025-01-12]
freecad/x_Crystal/MS1V_T1K_32.768KHZ_7PF_20PPM_TA.FCStd
2.76 x 8.10 x 2.08 mm
MS1V-T1K-000
MS1V-T1K-001
MS1V-T1K-002
MS1V-T1K-003
