trunksx64/KICAD_LIBRARY/freecad/x_Display_7Segment/KW2_S561AWB.FCStd

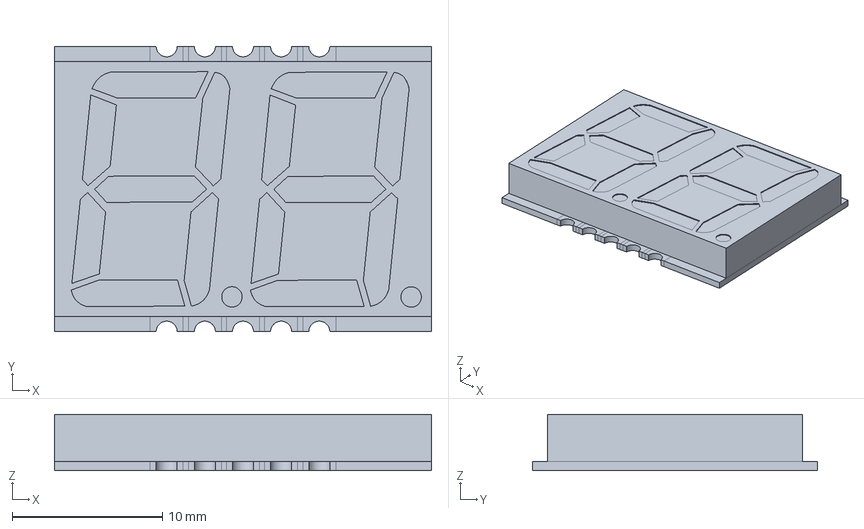
[picture p46: CAD file, 2025-07-22]
freecad/x_Display_7Segment/KW2_S561AWB.FCStd
25.1 x 19.0 x 3.75 mm
