trunksx64/KICAD_LIBRARY/freecad/x_Display_GLCD/GLCD_128x64__KS0108_DIP.FCStd

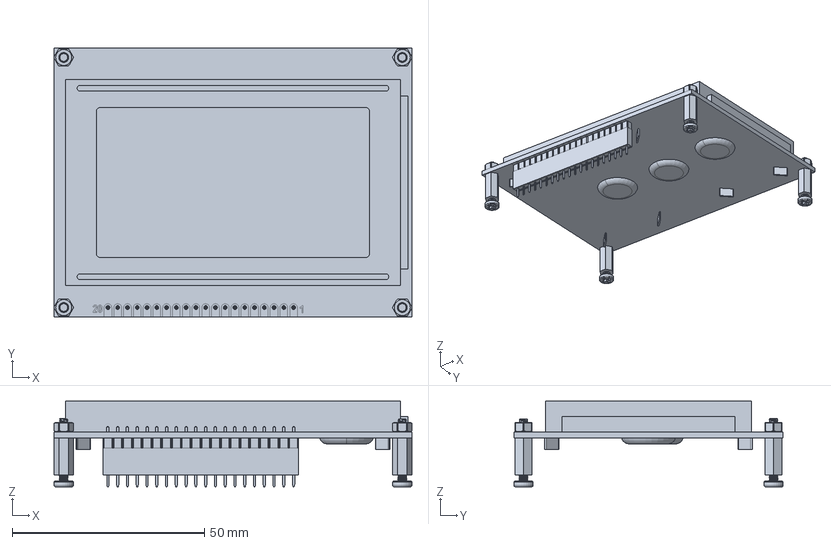
[picture p47: CAD file, 2025-07-24]
freecad/x_Display_GLCD/GLCD_128x64__KS0108_DIP.FCStd
93.0 x 70.0 x 22.3 mm
