trunksx64/KICAD_LIBRARY/freecad/x_Inductor_THT/TOROID_VERTICAL_D14.0mm_W7.0mm_P6.0mm.FCStd

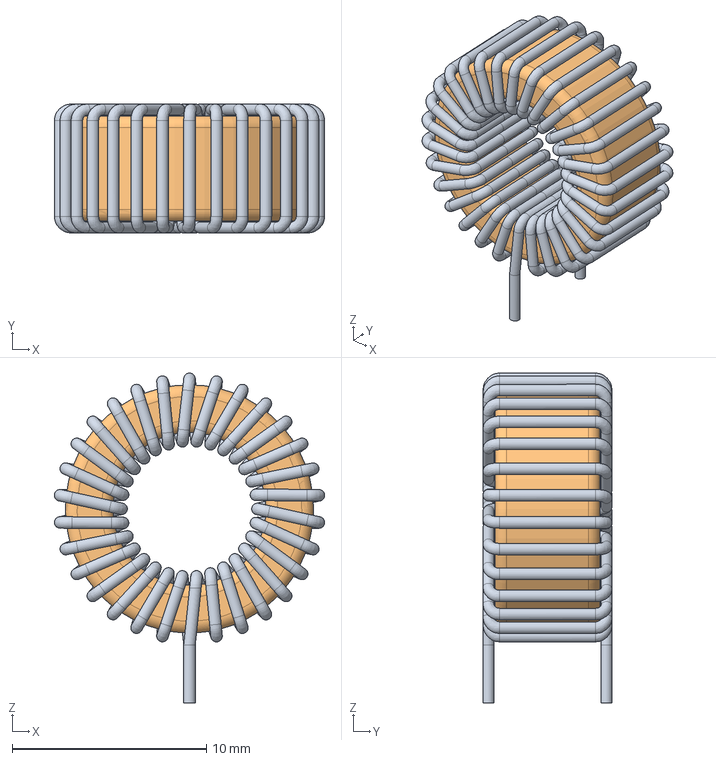
[picture p48: CAD file, 2025-01-12]
freecad/x_Inductor_THT/TOROID_VERTICAL_D14.0mm_W7.0mm_P6.0mm.FCStd
13.9 x 6.65 x 17.0 mm
WireCopper
FerritaBlack
