trunksx64/KICAD_LIBRARY/freecad/x_Joystick/JOYSTICK_THUMB.FCStd

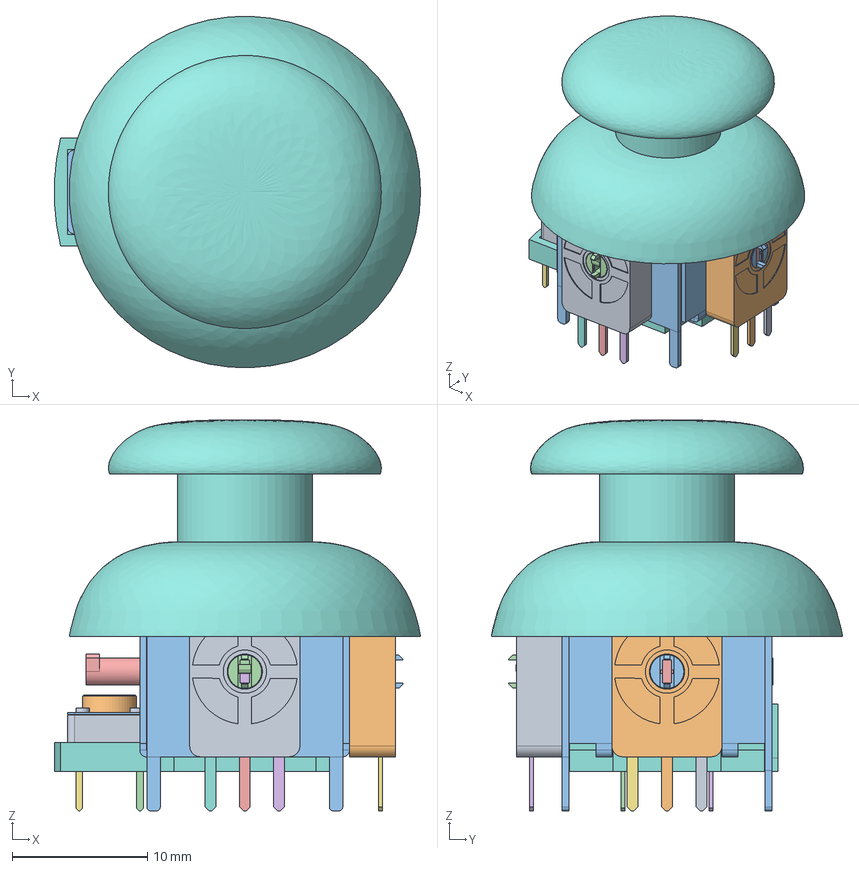
[picture p49: CAD file, 2025-01-12]
freecad/x_Joystick/JOYSTICK_THUMB.FCStd
27.1 x 26.0 x 28.9 mm
Pot_1_K
Pot_2_K
Eje_1_K
Eje_2_K
Pin_1_K
Pin_2_K
Pin_3_K
Pin_4_K
Pin_5_K
Pin_6_K
Shield_K
AxisX_K
AxisY_K
Axis_1_Z_K
Axis_2_Z_K
Base_K
Button_B_K
Button_P_K
Button_S_K
Pin_7_K
Pin_8_K
Pin_9_K
Pin_10_K
Thumb_K
