trunksx64/KICAD_LIBRARY/freecad/x_Jumpers/JUMPER_01x02_VERTICAL_2.54MM.FCStd

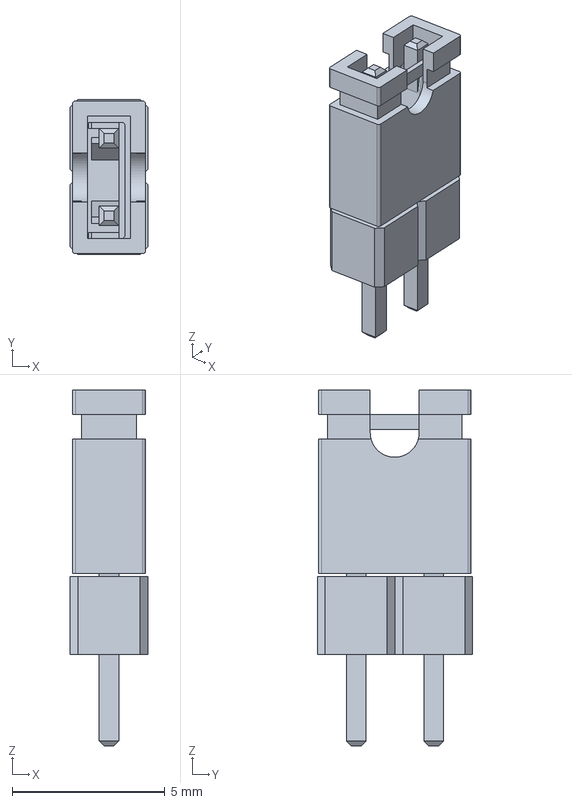
[picture p50: CAD file, 2025-01-12]
freecad/x_Jumpers/JUMPER_01x02_VERTICAL_2.54MM.FCStd
2.54 x 5.08 x 11.7 mm
