trunksx64/KICAD_LIBRARY/freecad/x_Module/BREAKOUT_BOAD_LQFN44.FCStd

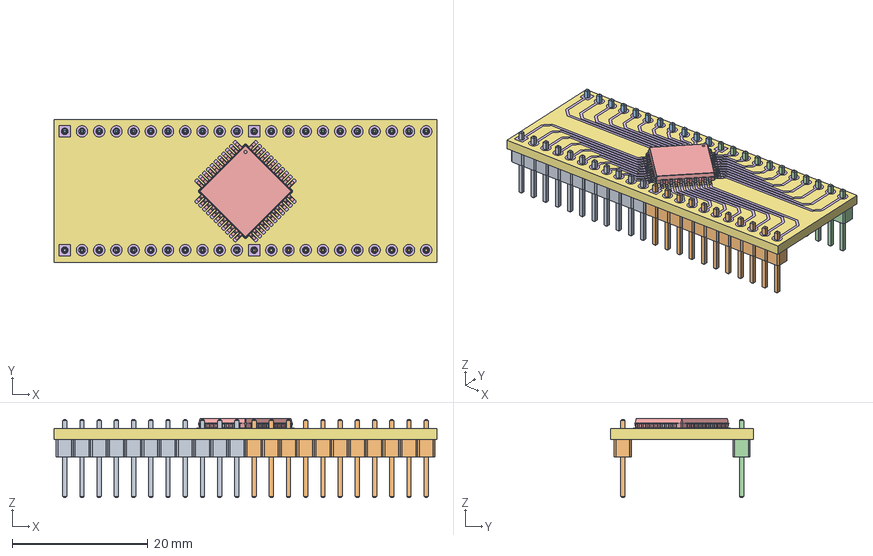
[picture p51: CAD file, 2025-01-12]
freecad/x_Module/BREAKOUT_BOAD_LQFN44.FCStd
56.5 x 21.1 x 11.7 mm
PIN_STRIP_11_PinHeader_1x11_P254mm_Vertical_5E59A88E
PIN_STRIP_11_STRIP_11_PinHeader_1x11_P254mm_Vertical_5E59A870
PIN_STRIP_11_STRIP_11_PinHeader_1x11_P254mm_Vertical_5E59A7DC
PIN_STRIP_11_STRIP_11_PinHeader_1x11_P254mm_Vertical_558B4E14
LQFP-44_LQFP_44_10x10mm_P08mm_5E28ACC7
topTracks_abf8
Pcb_abf8
