trunksx64/KICAD_LIBRARY/freecad/x_Package_DIP/DIP_8_W7.62mm_Socket.FCStd

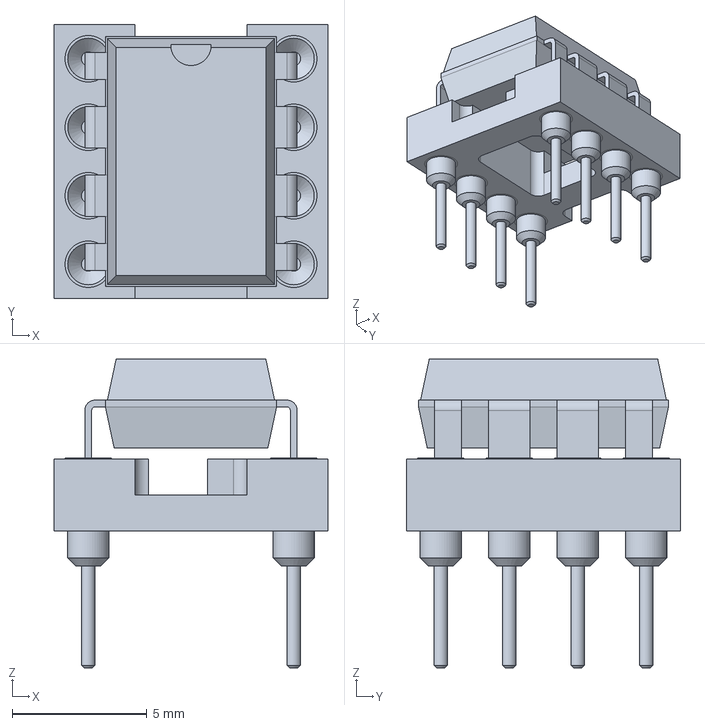
[picture p52: CAD file, 2025-01-12]
freecad/x_Package_DIP/DIP_8_W7.62mm_Socket.FCStd
10.2 x 10.2 x 11.5 mm
