trunksx64/KICAD_LIBRARY/freecad/x_Package_TO_SOT_THT/TO_220_3_Vertical_Heatsink_A.FCStd

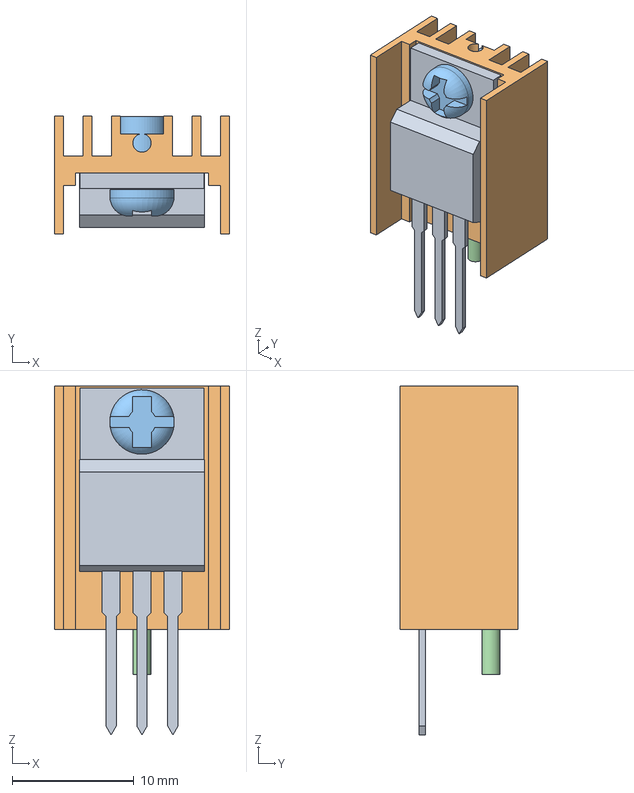
[picture p53: CAD file, 2025-09-22]
freecad/x_Package_TO_SOT_THT/TO_220_3_Vertical_Heatsink_A.FCStd
14.4 x 9.70 x 28.7 mm
TO-220-3_Vertical
HEADSINK
MOD_SCREW
POSTE
