trunksx64/KICAD_LIBRARY/freecad/x_Relay_THT/SH_124D1F.FCStd

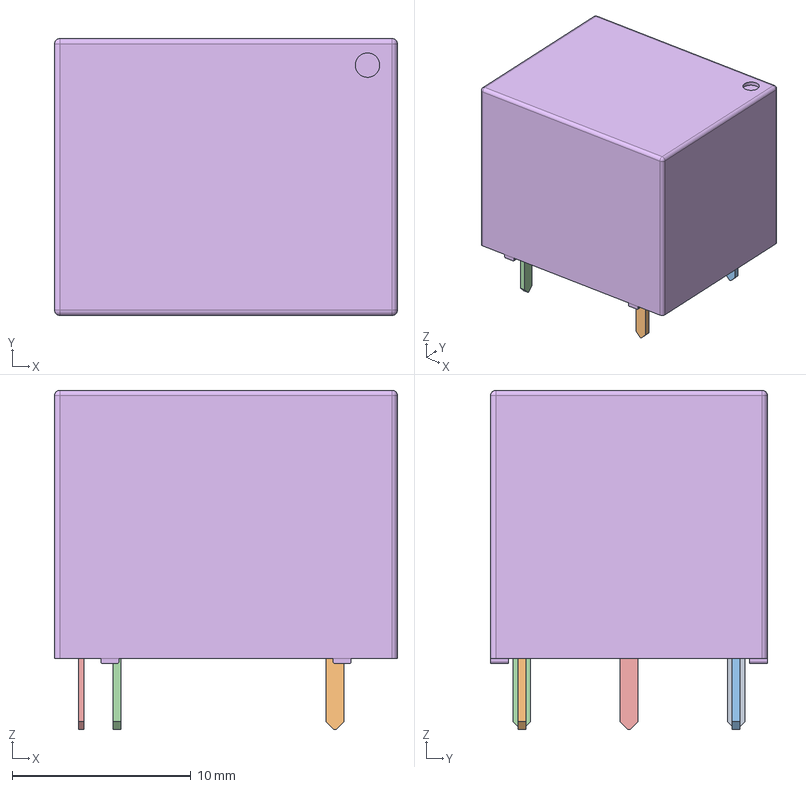
[picture p54: CAD file, 2025-01-12]
freecad/x_Relay_THT/SH_124D1F.FCStd
19.2 x 15.5 x 19.0 mm
PINA014
PIN016
PIN015
PINA013
PINA012
