trunksx64/KICAD_LIBRARY/freecad/x_RX_WiFi/DT_06_ESP_M2.FCStd

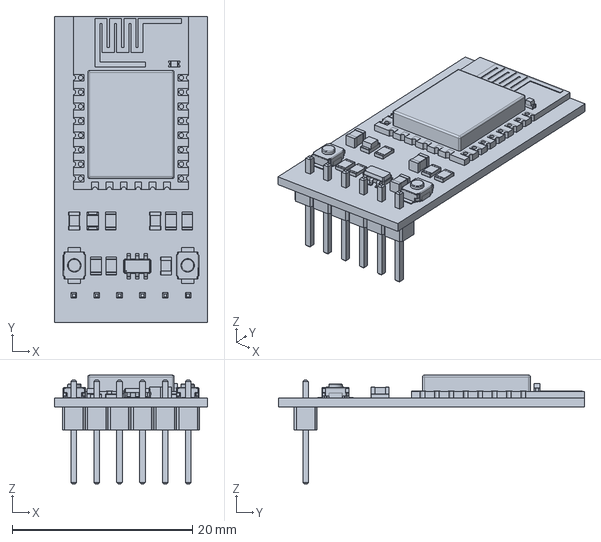
[picture p55: CAD file, 2025-01-12]
freecad/x_RX_WiFi/DT_06_ESP_M2.FCStd
17.0 x 34.0 x 12.1 mm
