trunksx64/KICAD_LIBRARY/freecad/x_Sockets_ZIF/SOCKET_16P_W35.2_H14.9_P7.62x2.45.FCStd

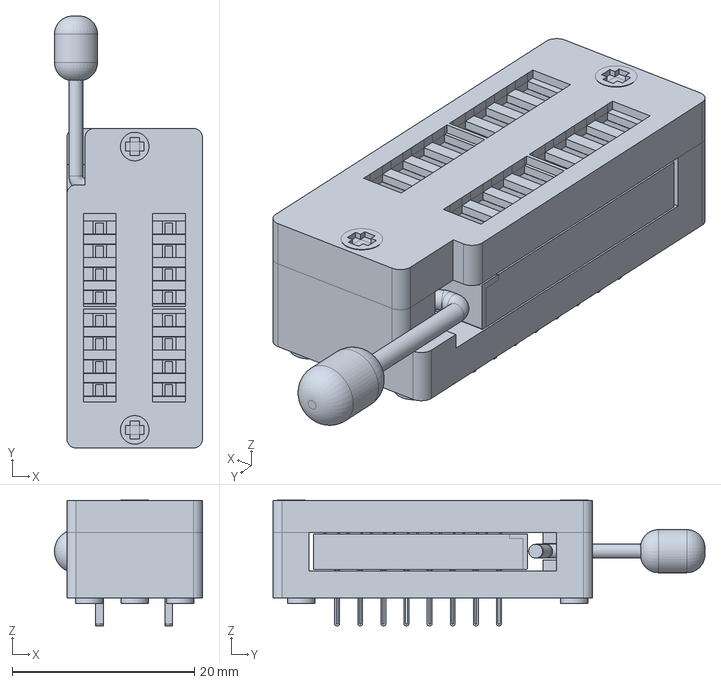
[picture p56: CAD file, 2025-07-22]
freecad/x_Sockets_ZIF/SOCKET_16P_W35.2_H14.9_P7.62x2.45.FCStd
16.3 x 47.5 x 13.8 mm
