trunksx64/KICAD_LIBRARY/3dmodels/x_Capacitors/SUPER_CAP_V_TYPE_D11.5mm_P5.0mm.step

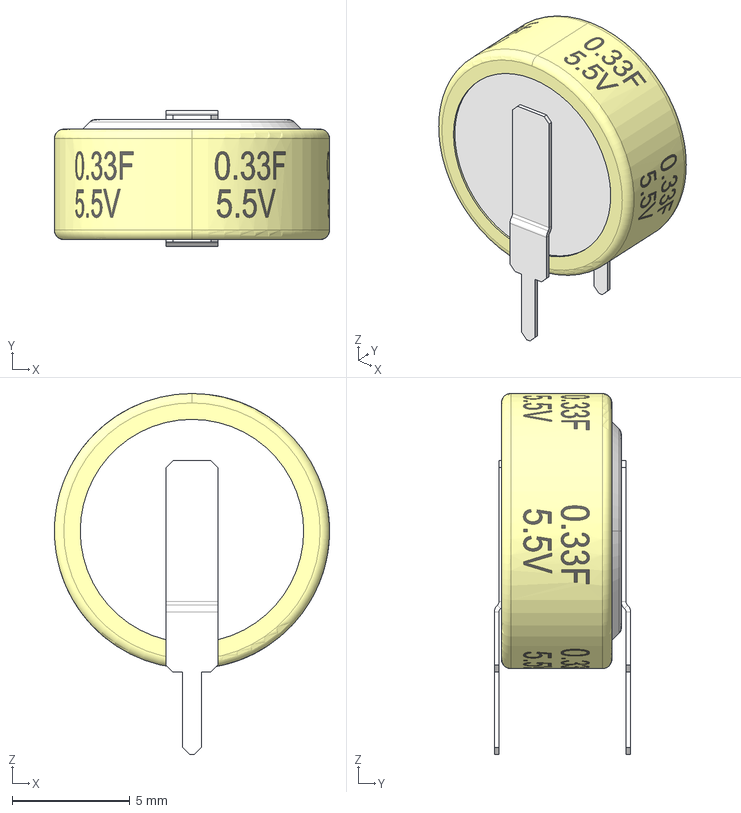
[picture p57: CAD file, 2024-07-13]
3dmodels/x_Capacitors/SUPER_CAP_V_TYPE_D11.5mm_P5.0mm.step
11.7 x 5.80 x 15.3 mm
SUPCAP-D1150X500.STP
SUPCAP-D1150X500-COVER.STP
SUPCAP-D1150X500-V-PIN.STP
SUPCAP-D1150X500-V-PIN.STP001
