trunksx64/KICAD_LIBRARY/freecad/x_Connector_Molex/MOLEX_MINI_FIT_02x03_P4.20mm_HORIZONTAL.FCStd

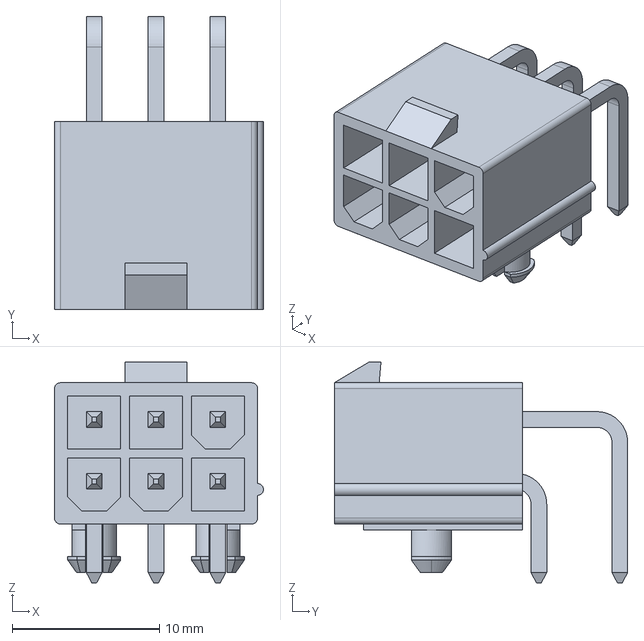
[picture p58: CAD file, 2025-01-12]
freecad/x_Connector_Molex/MOLEX_MINI_FIT_02x03_P4.20mm_HORIZONTAL.FCStd
14.2 x 19.9 x 15.0 mm
