trunksx64/KICAD_LIBRARY/freecad/x_Connector_USB/USB_MICRO_B_AMPHENOL_10118194_HORIZONTAL.FCStd

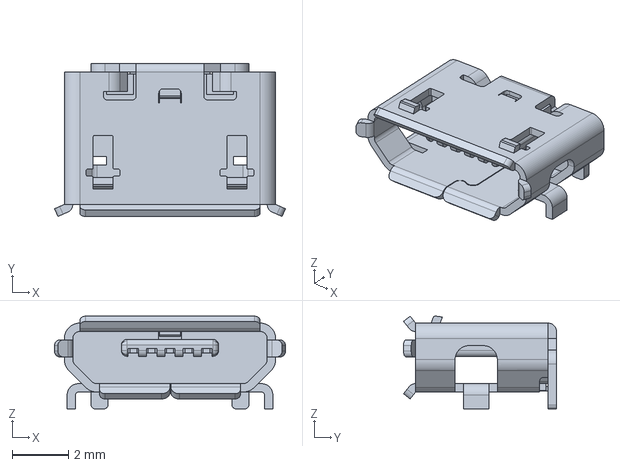
[picture p59: CAD file, 2025-01-12]
freecad/x_Connector_USB/USB_MICRO_B_AMPHENOL_10118194_HORIZONTAL.FCStd
8.20 x 5.43 x 3.30 mm
