trunksx64/KICAD_LIBRARY/freecad/x_Display_7Segment/XL_DB2381SRBC.FCStd

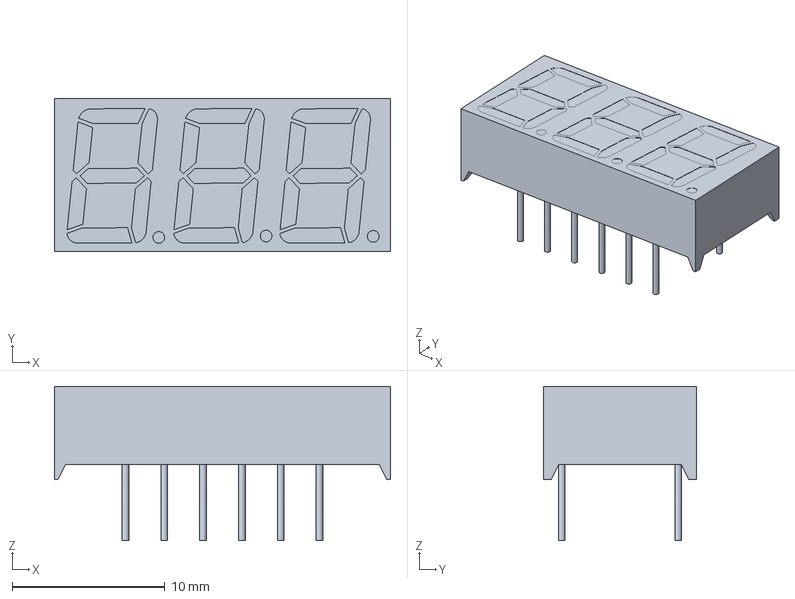
[picture p60: CAD file, 2025-07-06]
freecad/x_Display_7Segment/XL_DB2381SRBC.FCStd
22.0 x 10.0 x 10.1 mm
