trunksx64/KICAD_LIBRARY/freecad/x_Display_GLCD/GLCD_PCD8544_SMD.FCStd

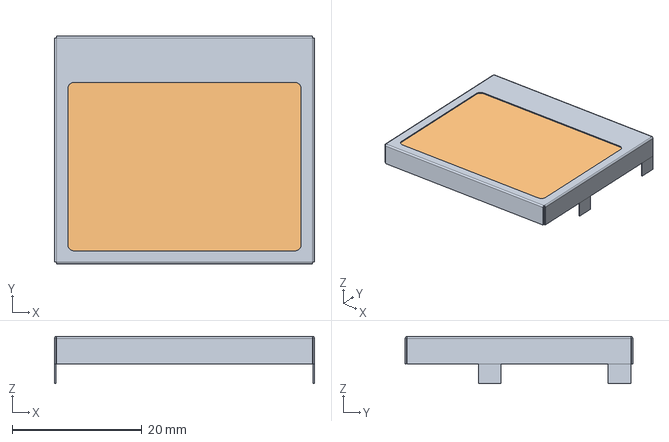
[picture p61: CAD file, 2025-01-12]
freecad/x_Display_GLCD/GLCD_PCD8544_SMD.FCStd
40.1 x 35.1 x 7.30 mm
Metal_Cover
Glass_Glcd
