trunksx64/KICAD_LIBRARY/freecad/x_Joystick/JOYSTICK_MINI.FCStd

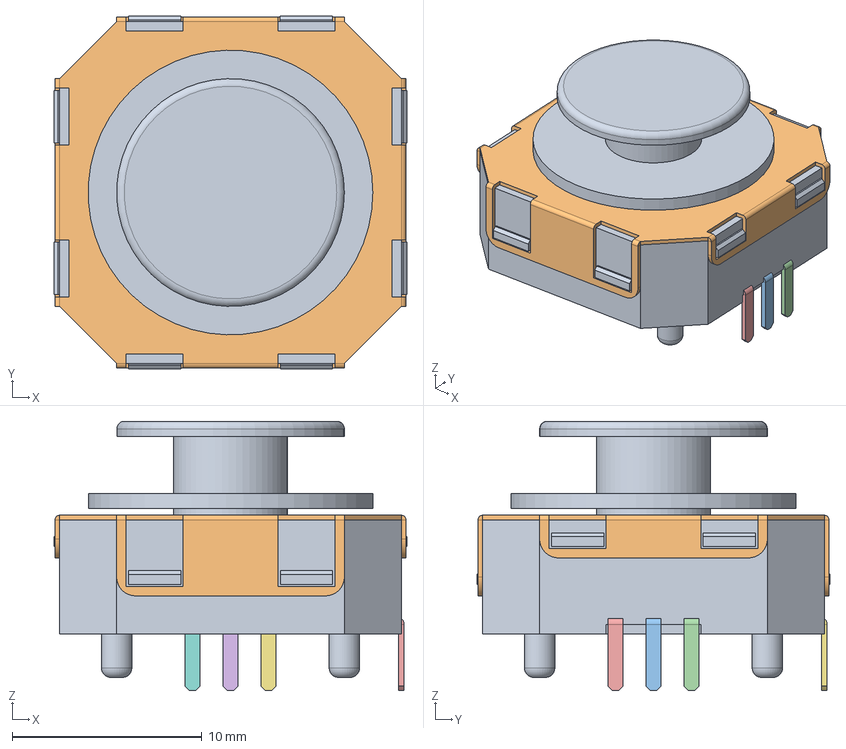
[picture p62: CAD file, 2025-01-12]
freecad/x_Joystick/JOYSTICK_MINI.FCStd
18.6 x 18.6 x 14.2 mm
Pin007
Pin008
Pin009
Pin010
Pin011
Pin012
Thumb002
