trunksx64/KICAD_LIBRARY/freecad/x_Jumpers/JUMPER_01x03_VERTICAL_2.54MM.FCStd

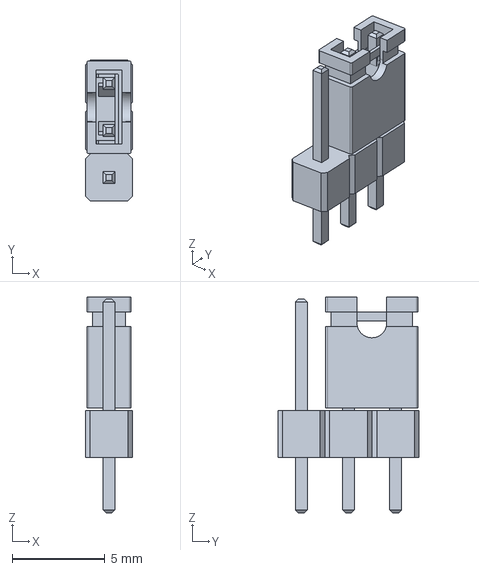
[picture p63: CAD file, 2025-01-12]
freecad/x_Jumpers/JUMPER_01x03_VERTICAL_2.54MM.FCStd
2.54 x 7.62 x 11.7 mm
