trunksx64/KICAD_LIBRARY/freecad/x_Module/BREAKOUT_BOAD_LQFN48.FCStd

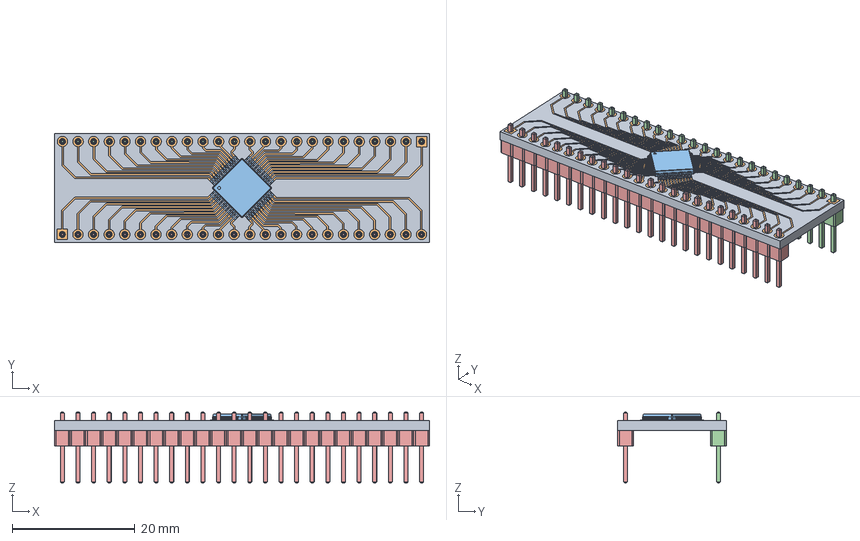
[picture p64: CAD file, 2025-01-12]
freecad/x_Module/BREAKOUT_BOAD_LQFN48.FCStd
61.0 x 17.8 x 11.5 mm
PCB
TRACKS
TQFP48
PIN_HEADER_001
PIN_HEADER_002
