trunksx64/KICAD_LIBRARY/freecad/x_Package_TO_SOT_THT/TO_220_3_Vertical_Heatsink.FCStd

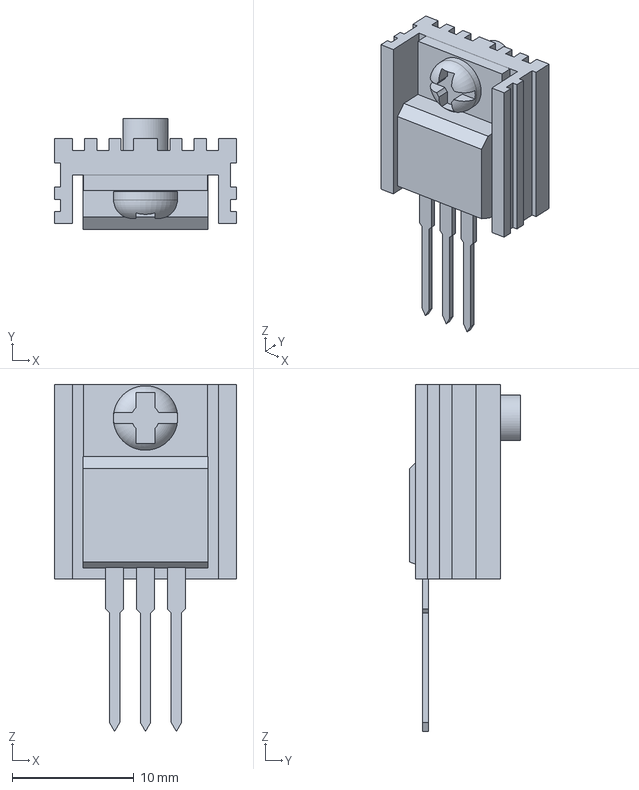
[picture p65: CAD file, 2025-01-17]
freecad/x_Package_TO_SOT_THT/TO_220_3_Vertical_Heatsink.FCStd
15.0 x 9.09 x 28.5 mm
