trunksx64/KICAD_LIBRARY/freecad/x_Relay_THT/SRA_12VDC_CL.FCStd

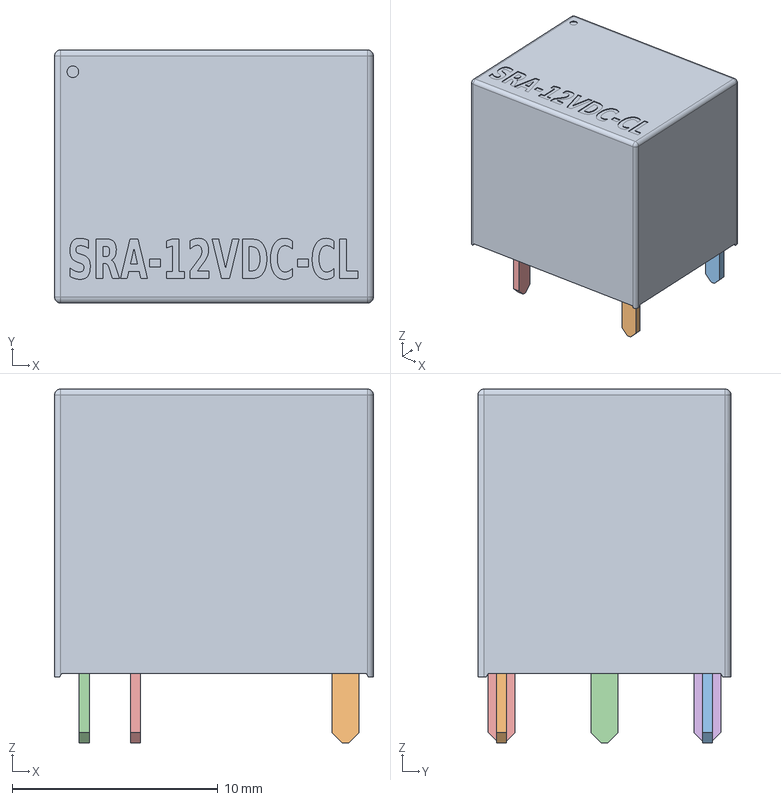
[picture p66: CAD file, 2025-01-12]
freecad/x_Relay_THT/SRA_12VDC_CL.FCStd
15.5 x 12.3 x 17.2 mm
Pin_006
Pin_007
Pin_008
Pin_009
Pin_010
