trunksx64/KICAD_LIBRARY/freecad/x_RX_WiFi/ESP_M3_THT.FCStd

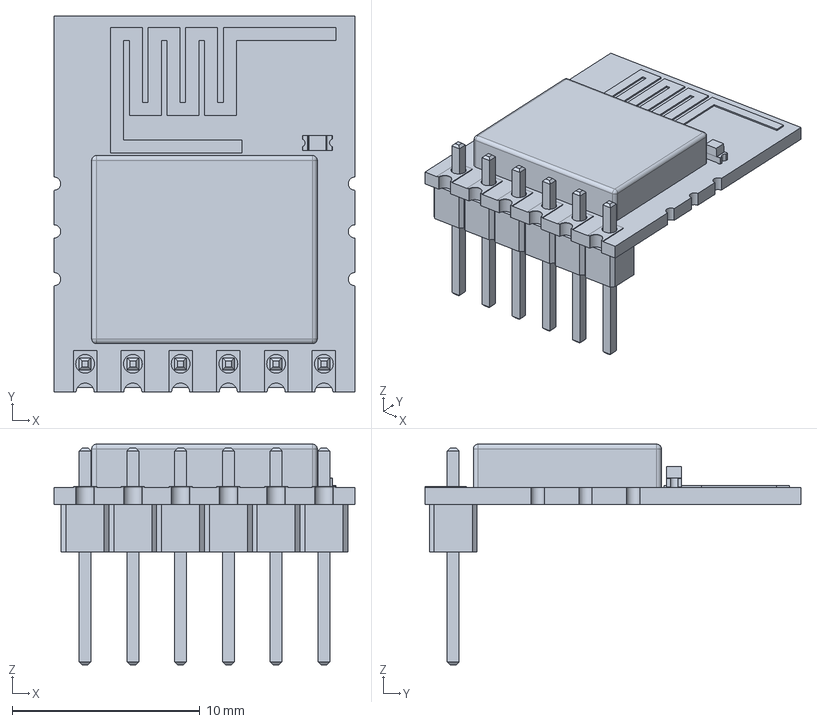
[picture p67: CAD file, 2025-01-12]
freecad/x_RX_WiFi/ESP_M3_THT.FCStd
16.0 x 20.0 x 11.7 mm
