trunksx64/KICAD_LIBRARY/freecad/x_Connector_Molex/MOLEX_KK_1x04_P2.54mm_HORIZONTAL.FCStd

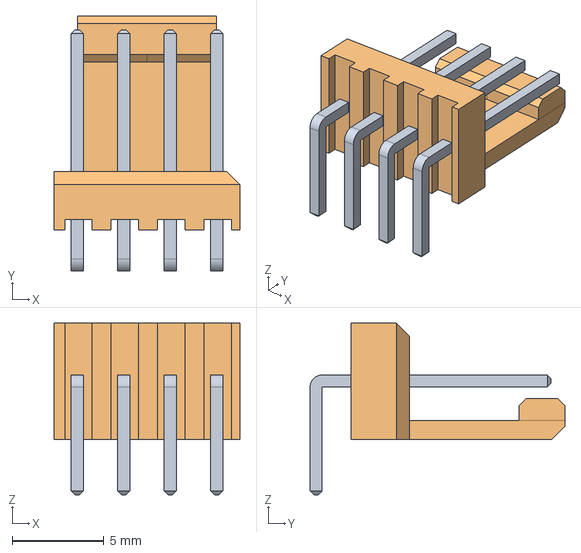
[picture p68: CAD file, 2025-01-12]
freecad/x_Connector_Molex/MOLEX_KK_1x04_P2.54mm_HORIZONTAL.FCStd
10.2 x 13.9 x 9.39 mm
ArrayP
Base
