trunksx64/KICAD_LIBRARY/freecad/x_Connector_USB/USB_C_HRO_TYPE_C_31_M_12.FCStd

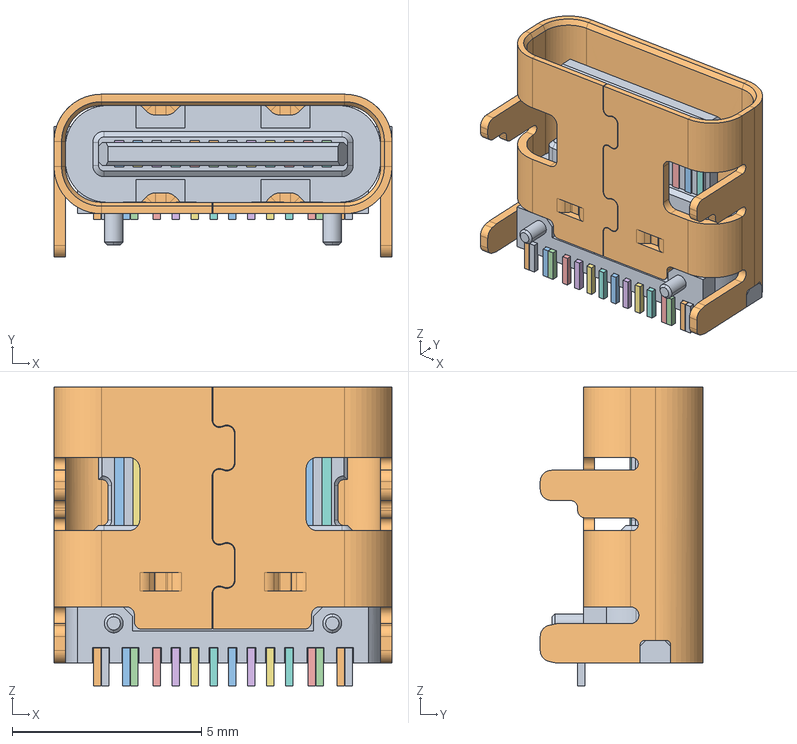
[picture p69: CAD file, 2025-01-12]
freecad/x_Connector_USB/USB_C_HRO_TYPE_C_31_M_12.FCStd
8.94 x 4.30 x 7.90 mm
