trunksx64/KICAD_LIBRARY/freecad/x_Package_TO_SOT_THT/TO_220_15_P2.54x2.54mm_Lead4.58mm_Vertical.FCStd

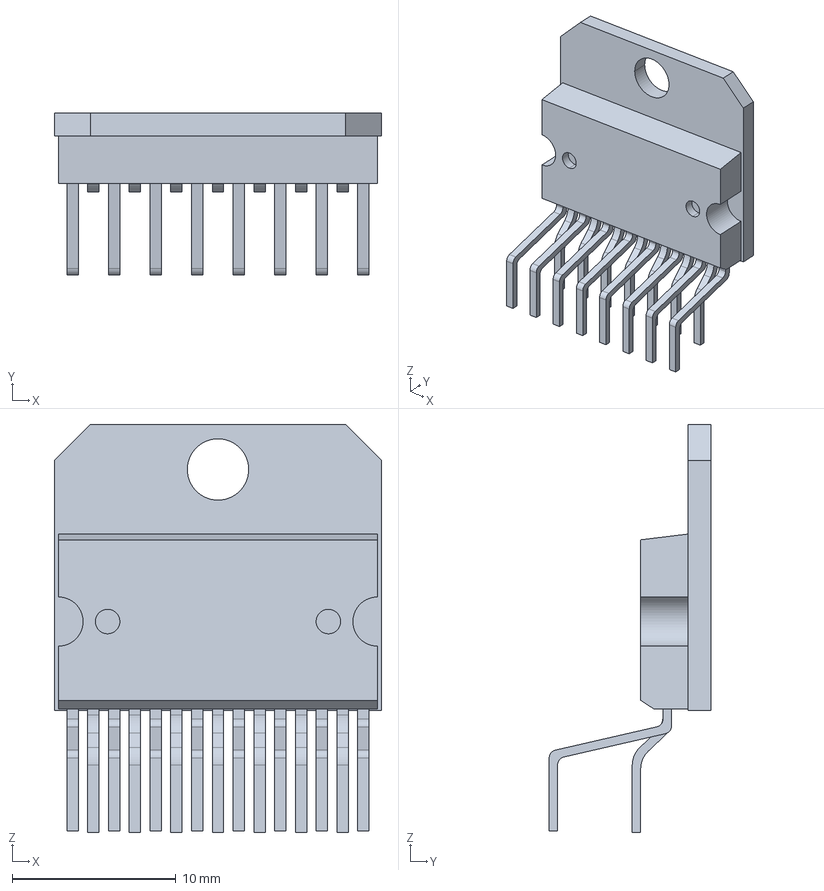
[picture p71: CAD file, 2025-01-12]
freecad/x_Package_TO_SOT_THT/TO_220_15_P2.54x2.54mm_Lead4.58mm_Vertical.FCStd
20.0 x 9.89 x 24.9 mm
