trunksx64/KICAD_LIBRARY/freecad/x_Relay_THT/G5NB_1A.FCStd

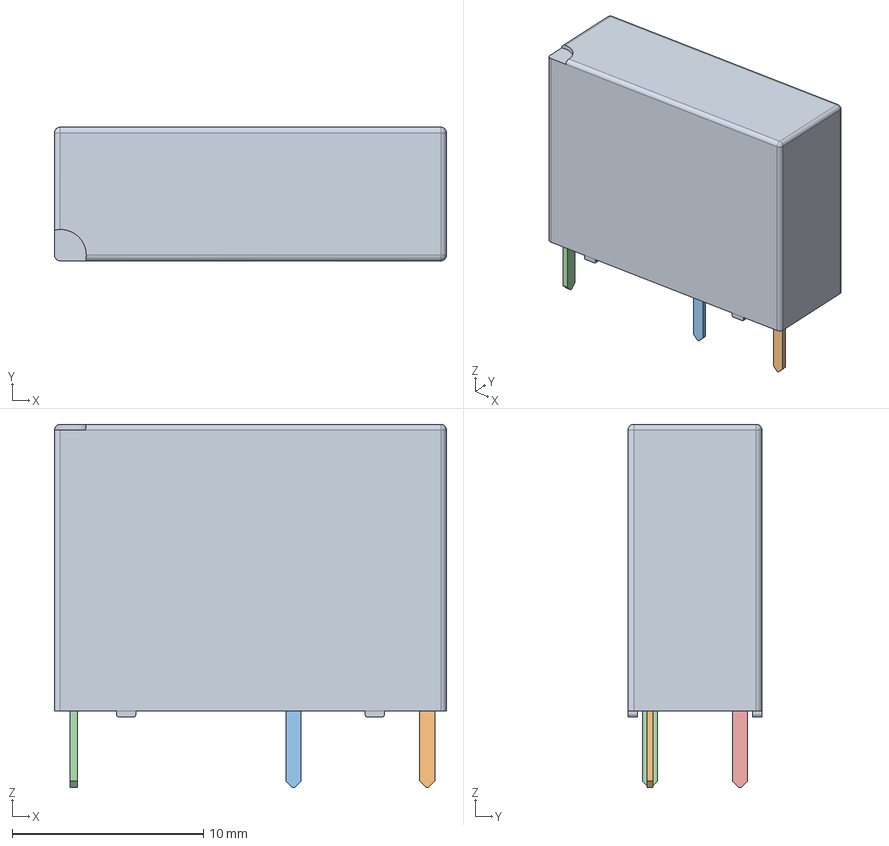
[picture p72: CAD file, 2025-01-12]
freecad/x_Relay_THT/G5NB_1A.FCStd
20.5 x 7.00 x 19.0 mm
PIN015
PIN016
PINA003
PINA004
