trunksx64/KICAD_LIBRARY/freecad/x_RX_WiFi/ESP_M3_SMD.FCStd

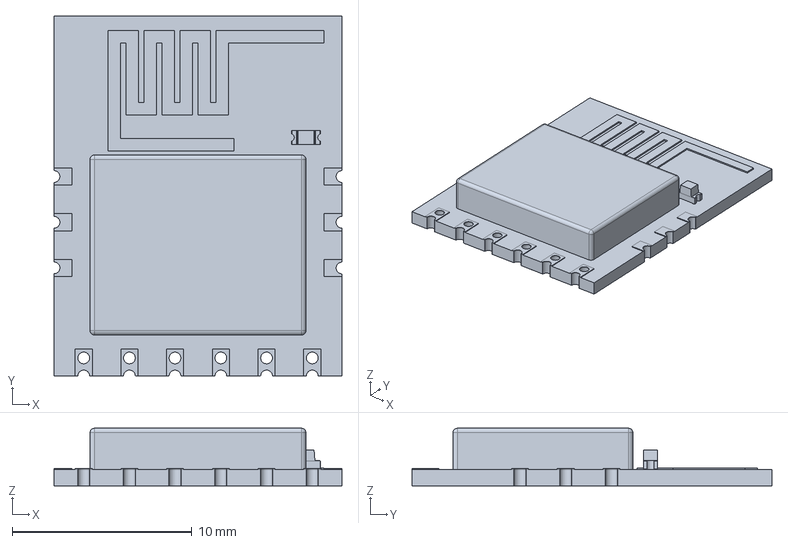
[picture p73: CAD file, 2025-01-12]
freecad/x_RX_WiFi/ESP_M3_SMD.FCStd
16.0 x 20.0 x 3.20 mm
