trunksx64/KICAD_LIBRARY/freecad/x_Connector_Molex/MOLEX_KK_1x05_P2.54mm_HORIZONTAL.FCStd

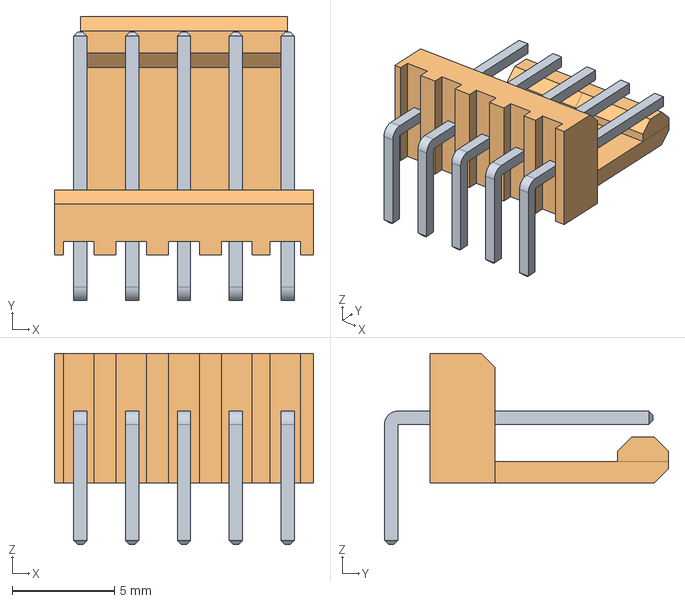
[picture p74: CAD file, 2025-01-12]
freecad/x_Connector_Molex/MOLEX_KK_1x05_P2.54mm_HORIZONTAL.FCStd
12.7 x 13.9 x 9.39 mm
ArrayP
Base
