trunksx64/KICAD_LIBRARY/freecad/x_Connector_USB/USB_MINI_B_PCB_MOUNT_180_DIP.FCStd

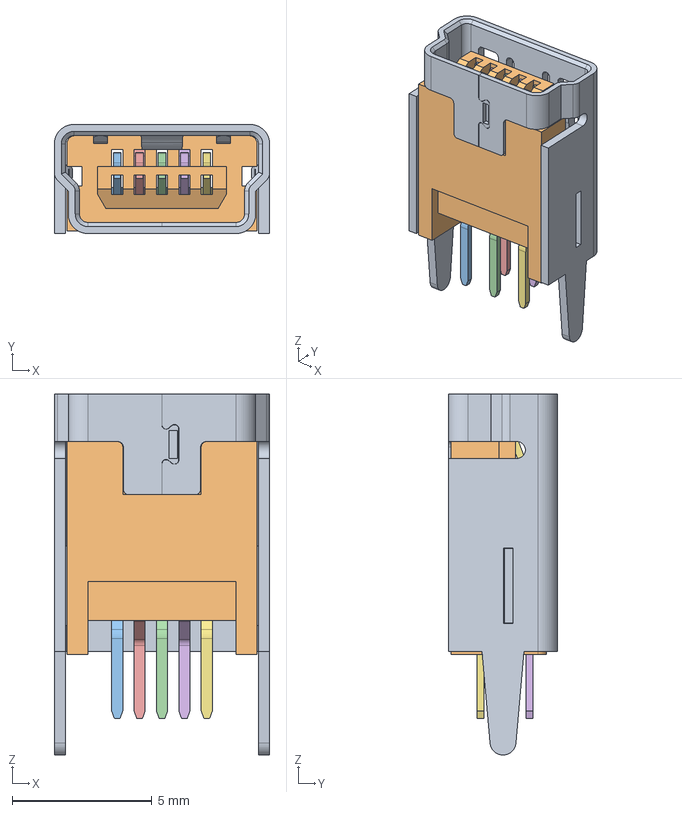
[picture p75: CAD file, 2025-01-12]
freecad/x_Connector_USB/USB_MINI_B_PCB_MOUNT_180_DIP.FCStd
7.70 x 3.90 x 12.9 mm
54-00023_shell
54-00023_insulator
54-00023_pin1
54-00023_pin3
54-00023_pin2
54-00023_pin4
54-00023_pin5
