trunksx64/KICAD_LIBRARY/freecad/x_Display_7Segment/LDS_5461XX.FCStd

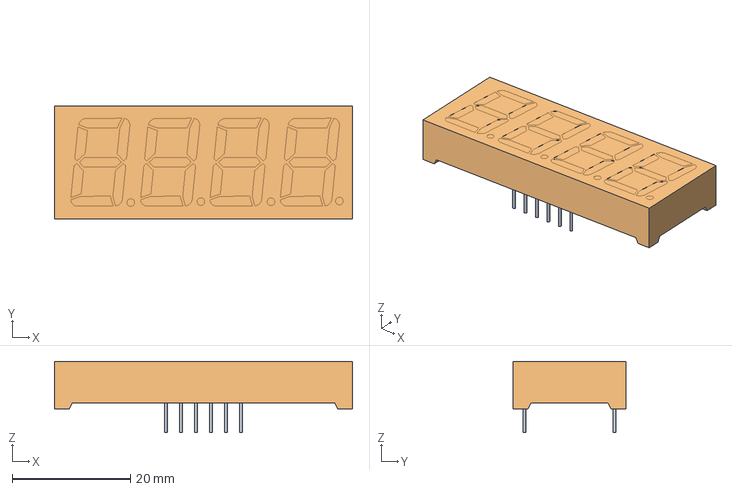
[picture p76: CAD file, 2025-01-12]
freecad/x_Display_7Segment/LDS_5461XX.FCStd
50.3 x 19.0 x 12.0 mm
Pins
LDS_5461BS
