trunksx64/KICAD_LIBRARY/freecad/x_Relay_THT/G2RL_14.FCStd

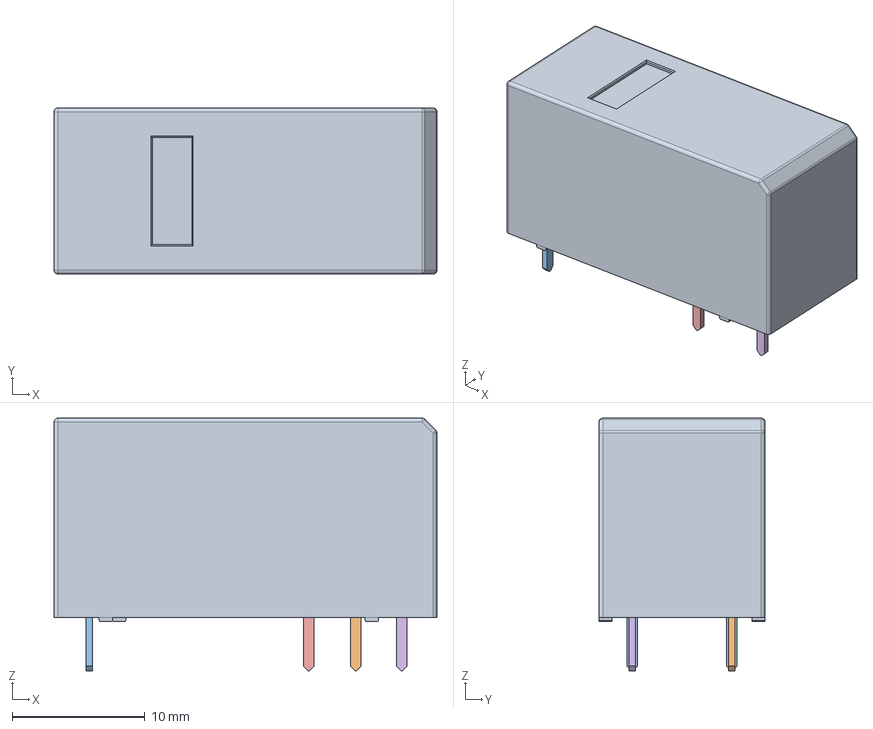
[picture p77: CAD file, 2025-01-12]
freecad/x_Relay_THT/G2RL_14.FCStd
28.8 x 12.5 x 19.0 mm
PIN020
PINA004
PINA003
PIN019
PIN018
