trunksx64/KICAD_LIBRARY/freecad/x_Connector_USB/USB_A_LP_C_ASSMANN.FCStd

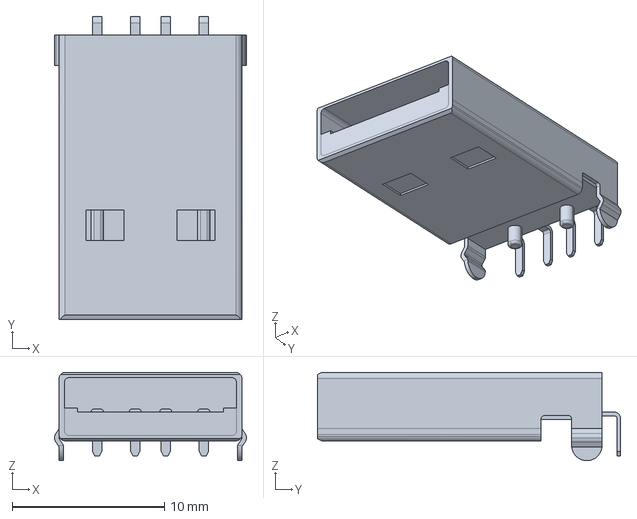
[picture p78: CAD file, 2025-01-12]
freecad/x_Connector_USB/USB_A_LP_C_ASSMANN.FCStd
12.6 x 19.9 x 5.80 mm
