trunksx64/KICAD_LIBRARY/freecad/x_Connector_USB/USB_A_MOLEX_67643_HORIZONTAL.FCStd

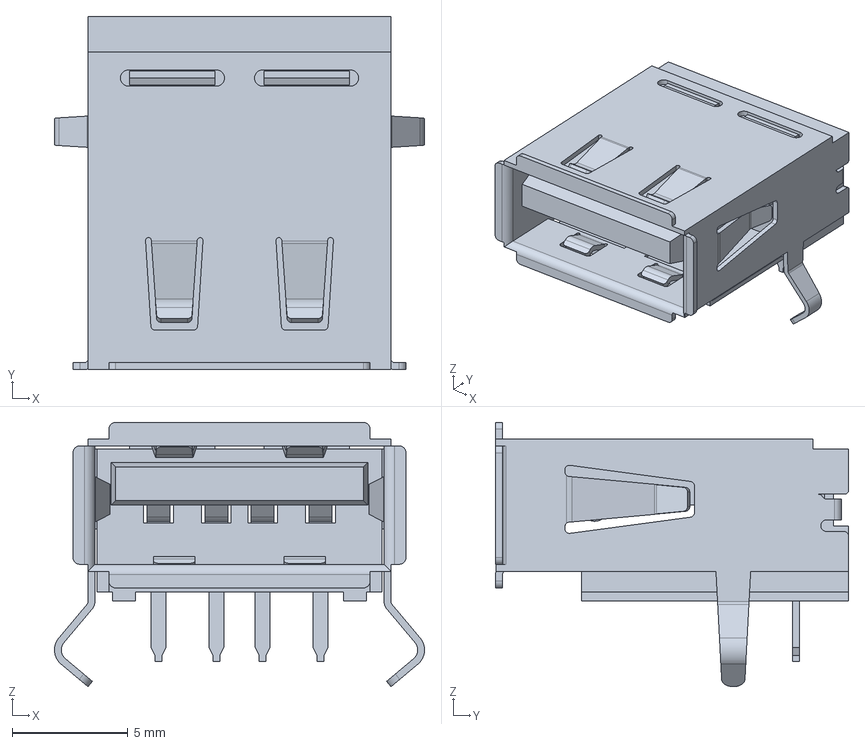
[picture p79: CAD file, 2025-01-12]
freecad/x_Connector_USB/USB_A_MOLEX_67643_HORIZONTAL.FCStd
16.0 x 15.3 x 11.4 mm
