trunksx64/KICAD_LIBRARY/(list of files, cad)

Other CAD files:
freecad/x_Buzzer/AT_1224_TWT_5V_2_R.FCStd
freecad/x_Capacitors/Cap_Disc_D5.0mm_W2.5mm_H7.8MM_P5.00mm.FCStd
freecad/x_Capacitors/KR-5R5V224-R.FCStd
freecad/x_Capacitors/SUPER_CAP_V_TYPE_D11.5mm_P5.0mm.FCStd
