trunksx64/KICAD_LIBRARY/(commit log)

2025-07-04 07/04/25/Update Library Connectors
2025-07-06 07/06/25/Add Display 7 Segments
    [XL-DB2281SRBC.FCStd, XL-DB2381SRBC.FCStd]
2025-07-08 07/07/25/Add Display KW2-S561AWB + KW3-S561AWB
    [KW2-S561AWB.FCStd, KW3-S561AWB.FCStd]
2025-07-22 07/22/25/Update Displays 7 Segment
    [Buzzer_12x9RM6.5.FCStd, KW2-S561AWB.FCStd, KW3-S561AWB.FCStd, SOCKET_16P_W35.2_H14.9_P7.62x2.45.FCStd, SOCKET_28P_W50.4_H14.9_P7.62x2.45.FCStd]
2025-07-24 07/24/25/Update Butons Tactiles
    [1088AS.FCStd, AC_COMMON_COIL_H16.2mm_W21.0mm_Py10.mm_Px13.mm.FCStd, ARDUINO_UNO_R3_PIN_HEADER.FCStd, AT-1224-TWT-5V-2-R.FCStd, AT-1224-TWT-5V-2-R.step, BREAKOUT_BOAD_LQFN44.FCStd, BREAKOUT_BOAD_LQFN48.FCStd, BREAKOUT_BOAD_LQFN64.FCStd]
2025-09-22 09/21/25/X/Add Seeed Studio ESP32-C3
    [AT-1224-TWT-5V-2-R.FCStd, AT-1224-TWT-5V-2-R.step, Cap_Disc_D5.0mm_W2.5mm_H7.8MM_P5.00mm.FCStd, Cap_Disc_D5.0mm_W2.5mm_H7.8MM_P5.00mm.step, DM3AT_SF_PEJM5.FCStd, GLCD_128x64 _KS0108_DIP.FCStd, GLCD_OLLED_128x32_I2C.FCStd, JUMPER_01x02_VERTICAL_2.54MM.FCStd]
2025-10-27 10/27/25/Add Connecotr FTSH for STM32 STLink-V3
    [FTSH-107-01-L-DV-K.FCStd, FTSH-107-01-S-D-K.FCStd, MS920SE-FL27E.FCStd, SEEED_STUDIO_XIAO_ESP32_C3.FCStd]
2026-01-05 05/01/26/ADD SOT-523
    [AT_1224_TWT_5V_2_R.FCStd, AT_1224_TWT_5V_2_R.step, DIP_8_W7.62mm_Socket.FCStd, DO_214AC(SMA).FCStd, DT_06_ESP_M2.FCStd, ESP_M3_SMD.FCStd, ESP_M3_THT.FCStd, FTSH_107_01_L_DV_K.FCStd]
2026-01-20 19/01/26/Update Address Directory 3D Models & Footprints
2026-01-21 20/01/26/Fixes Connector FTSH Footprint
2026-02-07 07/02/26/Minor Updates
    [AT_1224_TWT_5V_2_R.step, Cap_Disc_D5.0mm_W2.5mm_H7.8MM_P5.00mm.step, IDC_Header_2x07_P21.27mm_Vertical.FCStd, SUPER_CAP_V_TYPE_D11.5mm_P5.0mm.step]
2026-02-24 23/02/26/Update SuperCapacitor Model 3D
    [KR-5R5V224-R.FCStd, KR-5R5V224-R.step, SUPER_CAP_V_TYPE_D11.5mm_P5.0mm.step]
2026-02-24 23/02/26/SOT-523 Fixes Models 3D
    [SOT-523.FCStd]
2026-02-26 26/02/26/Update Name Directory + Models 3D for Kicad 9
    [SUPER_CAP_V_TYPE_D11.5mm_P5.0mm.step]
2026-03-22 03/22/26/Update Struct for Kicad 10 + Remove Models 3D .wrl + Minor Fixes
    [AT_1224_TWT_5V_2_R.step, Cap_Disc_D5.0mm_W2.5mm_H7.8MM_P5.00mm.step, KR-5R5V224-R.step, SUPER_CAP_V_TYPE_D11.5mm_P5.0mm.step]
